ChiThang12/Design_SoC_RISCV_ASCON/paper2/paper2_2/H1+H3.md

📋 BRIEFING DOCUMENT TỔNG HỢP – H1 + H3 TRÊN NỀN DUAL-CORE
1. BỐI CẢNH VÀ ĐỊNH HƯỚNG
Nền tảng: SoC RISC-V 5-stage, AXI4 crossbar, DCache/ICache, ASCON crypto accelerator với DMA.

Vấn đề gốc: DMA và cache không đồng bộ, phần mềm phải dùng fence/flush/invalidate nên tốn cycles và làm driver phức tạp.

Baseline đã khóa: selective coherent DMA và dual-core coherency đã có functional closure. Điều đó không còn là mục tiêu chính nữa, mà là nền ổn định để chuyển sang hai hướng mới:
- H3: Multi-Context ASCON
- H1: Compute-in-Cache

Mục tiêu hiện tại:
- chốt H3 trước để có kiến trúc context switching rõ ràng
- sau đó mở H1 để đẩy bài toán từ coherency sang processing tại chỗ trong cache

2. NỀN TẢNG ĐÃ ỔN
2.1. Những gì đã hoàn thành
Thành phần	Mô tả	Trạng thái
CPU Core 0 & 1	Hai instance của CPU RISC-V 5-stage, mỗi core có `mhartid` riêng.	✅ Tích hợp
ICache 0 & 1	Cache lệnh riêng.	✅ Tích hợp
DCache 0 & 1	Đã nâng cấp từ valid/dirty sang MESI (I/S/E/M).	✅ Hoàn thành
Snoop Bus 2-way	`dcache_snoop_bus_2way.v` broadcast snoop request đến cả 2 DCache.	✅ Đã code và test
Snoop Arbiter 3-to-1	`dcache_snoop_arb_3to1.v` cấp quyền snoop công bằng hơn.	✅ Đã code
CPU miss -> peer snoop	Khi CPU1 read miss, nó tự động snoop CPU0 để lấy data mới nhất.	✅ Đã chứng minh
DMA sideband snoop	`tb_ascon_dma.v` pass, chứng minh DMA có thể snoop read và invalidate.	✅
Firmware dual-core	`basic`, `cache_sweep`, `fence_flush`, `peer_snoop` đều PASS.	✅
ASCON DMA end-to-end dual-core	`test_dualcore_ascon_dma_coherent` PASS ở mức SoC dual-core.	✅

2.2. Ý nghĩa của baseline
- Đây là nền đủ chắc để không phải quay lại sửa coherency core nữa.
- Đây là phần H3/H1 sẽ kế thừa, không phải phần cần mở rộng thêm trước tiên.
- Mọi số liệu mới nên được gắn vào H3/H1, không chỉ dừng ở “dual-core pass”.

2.3. Baseline số liệu đã chốt cho paper
Các số đo dưới đây đã được refresh ngày 2026-06-29 từ unified SoC TB:

| Chỉ số baseline | Giá trị |
| --- | ---: |
| `test_dualcore_peer_snoop` consumer `c2c_fwds` | 3 |
| `test_dualcore_peer_snoop` consumer `peer_snp_hits` | 3 |
| `test_dualcore_ascon_dma_coherent` `core0_dc_req_count` | 12437 |
| `test_dualcore_ascon_dma_coherent` `core1_dc_req_count` | 12527 |
| contention `forward-hit + DMA` cycles | 49957 |
| contention `forward-hit + DMA` consumer `c2c_fwds` | 10 |
| contention `fallback-refill + DMA` cycles | 81320 |
| contention `fallback-refill + DMA` consumer `c2c_fwds` | 2 |

Ý nghĩa trực tiếp cho bài báở:
- baseline coherency không chỉ pass chức năng mà còn đã có counter định lượng cho peer snoop và direct cache-to-cache forwarding
- dưới tải CPU/DMA đồng thời, direct forwarding cho completion time thấp hơn rõ rệt: `49957` cycles so với `81320` cycles
- tỷ lệ cải thiện hiện tại là khoảng `1.63x`, đủ tốt để dùng làm mốc so sánh khi mở H3 và H1

3. H3 TRƯỚC, RỒI MỚI H1
3.1. H3 – Multi-Context ASCON
Ý tưởng: ASCON core lưu nhiều context (key, nonce, state) trong một Context Register File (CRF). CPU/DMA chỉ cần gửi `context_id` khi khởi tạo, ASCON sẽ switch context nhánh mà không cần lưu/load qua bus.

Lợi ích:
- giảm overhead context switch từ hàng trăm cycles xuống rất thấp
- hỗ trợ nhiều ứng dụng/người dùng cùng lúc trên các core khác nhau
- giữ isolation giữa các context

Kế thừa từ baseline:
- đã có dual-core để chia workload theo core
- đã có DMA `coh_ctrl` và sideband path để thread thêm `context_id`
- đã có firmware/testbench framework để đo context overhead

3.2. H1 – Compute-in-Cache
Ý tưởng: Đưa một ASCON datapath nhỏ vào DCache Controller. Khi CPU hoặc DMA truy cập vùng crypto, cache controller tự xử lý dữ liệu ngay trong cache line, giảm data movement qua accelerator.

Lợi ích:
- giảm traffic bus giữa cache và accelerator
- tăng locality và giảm latency cho dữ liệu đã được xử lý
- mở hướng kiến trúc “compute at the edge of the cache”

Rủi rõ chính:
- latency nếu line chưa được xử lý xong
- complexity ở metadata và queueing
- phải giữ coherency hiện tại không vỡ

Giải pháp dự kiến:
- thêm `crypto_pending` cho line đang chờ xử lý
- thêm queue/batching cho các line crypto
- chỉ áp dụng cho vùng địa chỉ crypto, không đụng vùng còn lại

4. ROADMAP HIỆN TẠI
Giai đoạn 0: Chốt H3 trên baseline dual-core
Tuần	Công việc
1	Thêm `context_id` plumbing từ ASCON top xuống DMA và firmware.
2	Thêm `CONTEXT_SEL` / CRF và viết TB dual-core cho 2 context độc lập.
Sản phẩm: H3 baseline hoàn chỉnh.

Giai đoạn 1: Đo và chốt số liệu H3
Tuần	Công việc
1	Đở throughput theo số context.
2	Đở context-switch latency và isolation overhead.
3	So sánh baseline DMA vs H3.
Sản phẩm: paper H3.

Giai đoạn 2: Mở H1
Tuần	Công việc
1-2	Thiết kế `crypto_pending` và queue/batching trong DCache.
3-4	Tích hợp ASCON datapath thử nghiệm vào DCache.
5	Viết TB: CPU ghi plaintext -> cache xử lý -> CPU đọc ciphertext.
6	Đở throughput, latency, energy proxy.
Sản phẩm: paper H1.

Giai đoạn 3: Tổng hợp H1 + H3
- Nếu H3 và H1 đều ổn, có thể gộp thành một story lớn về crypto accelerator with multi-context and compute-in-cache support.

5. THỨ GÌ CẦN ĐỞ THÊM
Để H1/H3 đủ “paper-ready”, còn thiếu các nhóm số liệu sau:
- H3: context-switch latency, throughput theo số context, isolation overhead
- H1: latency, throughput, energy proxy, queue occupancy
- baseline comparison: selective coherent DMA vs H3 vs H1
- system metrics: miss/hit rate theo benchmark H3/H1, và bảng so sánh tiếp nói trên baseline contention đã có

6. TÀI LIỆU THAM CHIẾU
Các file đang nên đọc cùng nhau:
- `paper2/paper2_2/dualcore_test_results.md`
- `paper2/paper2_2/dualcore_missing_items.md`
- `paper2/paper2_2/rtl_coherency_checklist.md`
- `paper2/paper2_2/rtl_coherency_audit.md`
- `paper2/paper2_2/dualcore_test_commands.md`

7. KẾT LUẬN NGẮN
- Dual-core coherency đã là baseline ổn định.
- H3 là bước tiếp theo hợp lý nhất vì nó mở rộng control plane của ASCON mà chưa phá data path.
- H1 là bước tiếp theo sau H3 vì nó cần nền coherency đã ổn để nhúng compute vào cache.
- Từ thời điểm này, tài liệu trong `paper2/paper2_2` nên được đọc như một bộ chốt cho H1/H3, không còn là một paper dual-core riêng lẻ.
