ChiThang12/Design_SoC_RISCV_ASCON/plan/weak1/EXECUTIVE_SUMMARY.md

# EXECUTIVE SUMMARY - RISC-V CPU-HS Analysis

**Analysis Date:** May 1, 2026  
**Target:** High-Performance 5-stage Pipeline RISC-V CPU (without Multiplier)  
**Scope:** Bug analysis + fix recommendations

---

## KEY FINDINGS

### ✅ ASSESSMENT: 100% CORRECT

Báo cáo ban đầu **100% chính xác** khi loại bỏ multiplier issues.

**3 CRITICAL BUGS xác nhận:**

1. **FENCE Deadlock** - 🔴 **BLOCKING**
   - **What:** FENCE instruction causes permanent pipeline stall khi có pending load + store
   - **Why:** `req_ready = fence ? 0` blocks drain FSM từ issuing requests
   - **Scenario:** `lw x1 (miss) → sw x2 → fence` → **CRASH**
   - **Fix:** Allow drain to proceed independently of fence signal

2. **LSU Cache Miss Hazard** - 🔴 **BLOCKING**
   - **What:** Hazard detection không track multi-cycle load latency chính xác
   - **Why:** Scoreboard chỉ biết "load pending" không biết "khi nào ready"
   - **Scenario:** Load miss (10 cycles) + dependent instruction → stall time không đúng
   - **Fix:** Export `load_multi_cycle` signal, adjust stall calculation

3. **IRQ Timing Race** - 🟡 **EDGE CASE**
   - **What:** If `irq_pending` and `irq_flush_done` both high → race condition
   - **Why:** `else if` precedence not explicit
   - **Impact:** IRQ latency variation, possible missed interrupt
   - **Fix:** Explicit `if-else` priority

---

## CRITICALITY MATRIX

```
          Probability    Impact    Fix Effort    ACTION
          -----------    ------    ----------    ------
FENCE     HIGH           CRASH     1 day         MUST FIX NOW
LSU       HIGH           WRONG     2 days        MUST FIX NOW
IRQ       MEDIUM         EDGE      2 hours       FIX AFTER OTHERS
```

---

## TIMELINE

| Phase | Task | Duration | Owner |
|---|---|---|---|
| **Week 1** | FENCE deadlock fix + test | 1 day | RTL Engineer |
| **Week 1** | LSU hazard fix + test | 2 days | RTL Engineer |
| **Week 1** | IRQ timing fix | 2 hours | Verification |
| **Week 2** | Integration + regression | 2 days | Verification |
| **Week 2** | Performance benchmark | 1 day | Perf Team |
| **Week 3** | Final sign-off | 1 day | Lead |

**Total before tape-out:** ~1.5 weeks

---

## IMPLEMENTATION GUIDES

### FENCE FIX (Recommended: Option B)

```verilog
// LSU.v - Add fence-pending tracking
reg fence_pending_r;
always @(posedge clk) begin
    if (fence && !lsu_idle) fence_pending_r <= 1'b1;
    else if (lsu_idle) fence_pending_r <= 1'b0;
end

// Drain FSM - Start drain when fence pending
if ((!sb_empty || fence_pending) && !load_using_dcache)
    drain_state <= DRAIN_REQ;
```

### LSU FIX

```verilog
// LSU.v - Export load state
output wire load_multi_cycle;
assign load_multi_cycle = (load_state == LOAD_DCACHE);

// hazard_detection.v - Use load latency info
assign lsu_dep_stall = lsu_dependency_stall || 
                       (lsu_dependency_stall && load_multi_cycle);
```

### IRQ FIX

```verilog
// riscv_cpu_core_v2.v - Explicit priority
else if (irq_flush_done)       // Priority 1: clear
    irq_pending_lat <= 1'b0;
else if (irq_pending)           // Priority 2: set
    irq_pending_lat <= 1'b1;
```

---

## TESTING REQUIREMENTS

### FENCE Deadlock
```risc-v
lw x1, BIG_OFFSET(x2)    # Cache miss
sw x3, 0(x4)              # Store 1
sw x5, 4(x4)              # Store 2
fence                      # Must not deadlock!
```

### LSU Cache Miss
```risc-v
lw x1, MISS(x2)           # 10+ cycle miss
add x3, x1, x4            # Should stall exactly right amount
```

### IRQ Timing
Simulate: IRQ assertion during flush → verify clean priority

---

## DESIGN IMPACT ASSESSMENT

| Fix | Code Impact | Performance | Risk |
|-----|---|---|---|
| FENCE | +15 lines | Neutral | Low - isolated to LSU |
| LSU | +5 lines | Neutral | Low - output signal only |
| IRQ | 3 lines | Neutral | Very low - edge case |

**Total:** ~23 lines of code, **backward compatible**, **low risk**

---

## VERIFICATION SIGN-OFF

- [ ] FENCE simulation passes (test deadlock case)
- [ ] LSU miss simulation passes (test hazard stall window)
- [ ] IRQ priority simulation passes (test race condition)
- [ ] Full regression suite passes
- [ ] Performance within spec
- [ ] Code review approved
- [ ] Ready for tape-out

---

## OPEN ITEMS

### FENCE
- [ ] Confirm with verification team on fence semantics
- [ ] Check if fence needs to block NEW requests (yes, req_ready stays 0)
- [ ] Ensure drain priority vs load priority is correct

### LSU
- [ ] Verify forwarding logic handles load result timing correctly
- [ ] Check coverage on multi-cycle load paths
- [ ] Performance impact of extra stall?

### IRQ
- [ ] Confirm IRQ latency requirement (<50 cycles? or faster?)
- [ ] Check if RISC-V privilege spec has strict requirements

---

## CONCLUSION

**Status:** 3 bugs confirmed, **all fixable in 1-2 weeks**

**Recommendation:** 
1. Apply FENCE fix IMMEDIATELY (highest priority)
2. Integrate LSU fix + comprehensive testing
3. Quick IRQ timing fix + edge case verification
4. Full regression before tape-out

**Go/No-Go for Tape-out:** **NO GO** until all 3 fixes verified
- FENCE deadlock = CPU unusable for shared memory code
- LSU miss hazard = potential data corruption
- IRQ timing = less critical but needs validation

---

## REFERENCE

- **Full Analysis:** ANALYSIS_SUMMARY.md
- **Code Patches:** FIXES_IMPLEMENTATION.md
- **Source Code:** All .v files included

Contact: RTL Verification Team for questions on implementation
