ChiThang12/Design_SoC_RISCV_ASCON/📄 PAPER 2.docx

📄 PAPER 2: Zero-Copy Coherent DMA + Address-Offset

Tiêu đề dự kiến: "Eliminating Software Cache Flush Overheads: A Hardware-Coherent DMA Engine for ASCON Cryptographic Accelerator on RISC-V"
Mục tiêu: Tập trung vào tối ưu hóa Hệ thống (Cache, Bus, DMA - Hướng #4).

Section | Nội dung cần điền | Gợi ý số từ
Abstract | (Viết sau cùng) Tóm tắt: (1) Vấn đề: DMA và Cache không đồng bộ, phần mềm phải flush/invalidate gây ra overhead lớn. (2) Giải pháp: Đề xuất cơ chế coherency phần cứng (Snoop + ATU) cho ASCON DMA. (3) Kết quả: Giảm 70% latency, loại bỏ hoàn toàn lệnh CBO, tiết kiệm năng lượng. | 150-200 từ
I. Introduction | Đoạn 1: Giới thiệu SoC RISC-V với DMA cho crypto. Đoạn 2: Vấn đề nhức nhối của hệ thống nhúng là sự không đồng bộ Cache-Memory khi DMA hoạt động (dẫn đến data corruption nếu không flush). Đoạn 3: Các giải pháp hiện tại (Linux DMA_API, Zicbom extension) đều là Software Coherency -> Tốn CPU cycles và phức tạp. Đoạn 4 (Đóng góp): Lần đầu tiên tích hợp cơ chế Snoop phần cứng và ATU (Address Translation Unit) cho DMA Crypto, biến DMA thành một "Master có nhận thức về Cache". | 400-500 từ
II. Background & Motivation | 2.1 RISC-V Cache & CMOs: Giải thích DCache (8KB), các lệnh CBO.CLEAN, CBO.INVAL trong extension Zicbom. 2.2 The Software Coherency Overhead: Đưa ra code mẫu (Pseudo-code) phần mềm phải flush trước khi chạy DMA và invalidate sau. Tính toán thời gian tốn kém cho 1KB dữ liệu. 2.3 Related Work: CHIMERA và Ma'at vẫn dùng phần mềm để làm việc này. Không có giải pháp HW Coherency. | 500-600 từ
III. Proposed Hardware-Coherent DMA | A. Address Translation Unit (ATU): Giải thích cơ chế ánh xạ địa chỉ ảo 0x2500_0000 sang địa chỉ thật 0x1000_0000 để CPU và DMA dùng chung vùng nhớ. B. Snoop Interface: Mô tả giao tiếp trực tiếp (point-to-point) giữa DMA và DCache Controller. C. Coherency Protocol (MESI/MEI): Mô tả cách DMA thay đổi trạng thái Cache (Modified -> Shared, hoặc Invalidate). D. DMA FSM Modification: Sơ đồ trạng thái mới của DMA (thay vì chỉ Read/Write, nó phải gửi Snoop_Req trước mỗi giao dịch). | 700-900 từ + 2 hình
IV. Verification & Evaluation | A. FPGA Prototyping: Cài đặt trên FPGA. B. Performance (Latency): So sánh thời gian thực hiện 1 phép mã hóa (Setup + DMA + Core) giữa Baseline (có flush) và Proposed (không flush). C. CPU Utilization: Đo % thời gian CPU bị stall do đợi cache flush. D. Bus Traffic: Đo số lượng giao dịch AXI giảm được (do không phải write-back dirty data vô ích). E. Energy Saving: Ước tính năng lượng tiết kiệm được (dựa trên toggle count). | 400-500 từ + Bảng so sánh
V. Conclusion | Khẳng định giải pháp phần cứng đã giải quyết được bài toán "cache coherency" cho Crypto Accelerator, giúp firmware đơn giản hơn và system mạnh mẽ hơn.

📄 BRIEFING DOCUMENT #2: PAPER ON HARDWARE-COHERENT DMA

Tiêu đề dự kiến: Eliminating Software Cache Flush Overheads: A Hardware-Coherent DMA Engine for ASCON Cryptographic Accelerator on RISC-V

1. Bối cảnh (Context)

- SoC RISC-V thường có cache (I-cache, D-cache) để tăng tốc CPU.
- DMA (Direct Memory Access) được dùng để chuyển dữ liệu giữa memory và ngoại vi mà không cần CPU.
- Trong SoC đề xuất, ASCON engine có DMA riêng để đọc plaintext và ghi ciphertext.

2. Vấn đề (Problem)

- Cache và DMA không đồng bộ: CPU ghi dữ liệu vào cache (write-back) nhưng DMA đọc từ memory → DMA đọc dữ liệu cũ. DMA ghi dữ liệu mới vào memory nhưng CPU đọc từ cache → CPU đọc dữ liệu cũ.
- Giải pháp hiện tại (Software Coherency): Phần mềm driver phải gọi lệnh CBO.CLEAN (flush) trước khi DMA đọc, và CBO.INVAL (invalidate) sau khi DMA ghi. Cách này tốn nhiều chu kỳ, tăng latency, và phức tạp cho lập trình viên.
- Các accelerator ASCON trước đây (CHIMERA, Ma'at, SCAIE-V) đều dùng software coherency này.

3. Điểm mới (Novelty)

- Lần đầu tiên đề xuất Hardware Cache Coherency cho DMA của ASCON trên RISC-V.
- DMA có khả năng Snoop vào DCache để lấy dữ liệu mới nhất (thay vì đọc từ memory) và invalidate cache lines sau khi ghi.
- Kết hợp Address Translation Unit (ATU) để CPU và DMA chia sẻ vùng nhớ ảo, không cần flush/invalidate thủ công.

4. Giải pháp tóm tắt (Proposed Solution)

- ATU (Address Translation Unit):
  - Ánh xạ địa chỉ ảo của DMA (0x2500_0000) sang địa chỉ thật trong memory (0x1000_0000).
  - Cho phép CPU và DMA làm việc trên cùng vùng nhớ vật lý một cách trong suốt.
- Snoop Interface (point-to-point):
  - DMA gửi request snoop tới DCache Controller trước khi đọc: "Địa chỉ X có trong cache không? Cho tao xin dữ liệu mới nhất."
  - DMA gửi request snoop sau khi ghi: "Tao vừa ghi vào địa chỉ Y, mày invalidate cache line đó đi."
- Coherency Protocol:
  - Sử dụng trạng thái MESI (Modified, Exclusive, Shared, Invalid) hoặc đơn giản hóa (MEI).
  - DCache Controller quản lý trạng thái và trả lời snoop.
- DMA FSM: Thêm các trạng thái SNOOP_READ, SNOOP_WRITE trước khi thực hiện AXI transaction.

5. Các công trình liên quan (Related Works) và hạn chế

Công trình | Cách xử lý coherency | Hạn chế
CHIMERA (2025) | Software flush/invalidate (dùng Zicbom) | Tốn CPU cycles, phức tạp driver
Ma'at (2026) | Software invalidate trước DMA đọc | Overhead lớn, không tối ưu
SCAIE-V (2025) | Software fallback với cache flush | Không hỗ trợ hardware snoop
Linux DMA-API | Software coherency (dùng APIs) | Phụ thuộc vào OS, overhead cao
ARM ACE (AXI Coherency) | Hardware snoop | Chưa được áp dụng cho RISC-V crypto DMA

=> Chưa có công trình nào implement hardware snoop cho DMA của ASCON trên RISC-V.

6. Số liệu cần đo và kỳ vọng (Expected Metrics)

Metric | Baseline (software flush) | Proposed (HW snoop) | Target Improvement
DMA setup latency (cycles) | đo | đo | giảm > 50%
Total encryption time (cycles) | đo | đo | giảm > 40%
CPU stall time (%) | đo | đo | giảm > 60%
Bus transactions (count) | đo | đo | giảm > 30%
Energy (μJ/op) | đo | đo | giảm > 30%
Driver code size (lines) | đo | đo | giảm > 50%

7. Các hình vẽ cần có (Key Figures)

- Fig 1: Sơ đồ tổng thể SoC với snoop path mới (DMA → DCache).
- Fig 2: Sơ đồ FSM của DMA với các trạng thái snoop.
- Fig 3: Biểu đồ so sánh latency giữa software flush và hardware snoop (bar chart).
- Fig 4: Biểu đồ giảm bus traffic và CPU stall (grouped bar chart).

8. Bảng so sánh cần có

- Bảng so sánh các phương pháp coherency (software vs hardware) về latency, CPU overhead, code complexity.
- Bảng so sánh resource utilization trước/sau khi thêm snoop (LUT, FF, routing).
