ChiThang12/Design_SoC_RISCV_ASCON/paper2/plan_paper2.md

# Xem `02_plan_new_arch.md`

File này đã được tách sang tài liệu chuẩn:
- `paper2/02_plan_new_arch.md`

Tài liệu gốc về mục tiêu kiến trúc mới vẫn được giữ nguyên, chỉ đổi vị trí để tách rõ:
- baseline kiến trúc cũ
- kế hoạch kiến trúc mới
- bảng so sánh kết quả
