ChiThang12/Design_SoC_RISCV_ASCON/memory/MEMORY_UPGRADE_ANALYSIS.md

# Memory Modules Analysis Report

## Executive Summary

**Kết luận**: CẦN upgrade 1 module và giữ nguyên 1 module:

### ✅ **inst_mem_axi_slave.v** - SẴN SÀNG cho ICache!
- Đã support **AXI4 Full** với burst read
- Có burst interface hoàn chỉnh (ARLEN, ARSIZE, ARBURST, RLAST)
- inst_mem.v đã có burst read state machine
- **KHÔNG CẦN SỬA**

### ❌ **data_mem_axi_slave.v** - CẦN UPGRADE lên AXI4 Full
- Hiện tại chỉ support **AXI4-Lite** (single transfer)
- Thiếu burst support (ARLEN, AWLEN, RLAST, WLAST)
- data_mem.v không có burst interface
- **CẦN UPGRADE** để DCache hoạt động tốt

---

## Detailed Analysis

### 1. inst_mem_axi_slave.v ✅

#### Current Status: READY FOR ICACHE

**Ports đã có:**
```verilog
// Read Address Channel
input [7:0]  S_AXI_ARLEN     ✅ Burst length
input [2:0]  S_AXI_ARSIZE    ✅ Transfer size
input [1:0]  S_AXI_ARBURST   ✅ Burst type

// Read Data Channel  
output       S_AXI_RLAST     ✅ Last transfer indicator

// Write Channels
// Properly tied off - returns SLVERR ✅
```

**Features:**
- ✅ AXI4 Full burst read support
- ✅ State machine handles burst transactions
- ✅ inst_mem.v has burst interface with:
  - burst_addr, burst_len, burst_req
  - burst_data, burst_valid, burst_last, burst_ready
- ✅ Read-only (write returns SLVERR)

**Compatibility with ICache:**
```
ICache → inst_mem_axi_slave
  ARADDR[31:0] → S_AXI_ARADDR[31:0]  ✅
  ARLEN[7:0]   → S_AXI_ARLEN[7:0]    ✅
  ARSIZE[2:0]  → S_AXI_ARSIZE[2:0]   ✅
  ARBURST[1:0] → S_AXI_ARBURST[1:0]  ✅
  RLAST        ← S_AXI_RLAST         ✅
  
Perfect match! 100% compatible!
```

**Verdict**: **NO CHANGES NEEDED** ✅

---

### 2. data_mem_axi_slave.v ❌

#### Current Status: NEEDS UPGRADE

**Current Interface: AXI4-Lite**
```verilog
// Missing AXI4 Full signals:
❌ input [7:0]  S_AXI_ARLEN     // Not present
❌ input [2:0]  S_AXI_ARSIZE    // Not present
❌ input [1:0]  S_AXI_ARBURST   // Not present
❌ output       S_AXI_RLAST     // Not present

❌ input [7:0]  S_AXI_AWLEN     // Not present
❌ input [2:0]  S_AXI_AWSIZE    // Not present
❌ input [1:0]  S_AXI_AWBURST   // Not present
❌ output       S_AXI_WLAST     // Not present
```

**Current Behavior:**
- Single transfer only (no burst)
- State machine: IDLE → WAIT → RESP (one beat)
- data_mem.v: Simple read/write, no burst interface

**Required Changes for DCache:**

DCache needs burst support for efficient line fills:
```
Cache line = 16 bytes (4 words)
→ Need 4-beat burst read
→ Need burst write for write-through
```

**Impact Assessment:**

| Operation | Current (AXI4-Lite) | Needed (AXI4 Full) | Impact |
|---|---|---|---|
| Read 4 words | 4 separate transactions | 1 burst (4 beats) | Critical |
| Write 1 word | 1 transaction | 1 transaction | OK |
| Write burst | N/A | 1 burst (optional) | Nice to have |

---

## Upgrade Strategy for data_mem_axi_slave.v

### Option 1: Full Upgrade (Recommended)

**Copy approach from inst_mem_axi_slave.v:**

```verilog
// 1. Add AXI4 Full ports
input [7:0]  S_AXI_ARLEN,
input [2:0]  S_AXI_ARSIZE,
input [1:0]  S_AXI_ARBURST,
output       S_AXI_RLAST,

input [7:0]  S_AXI_AWLEN,
input [2:0]  S_AXI_AWSIZE,
input [1:0]  S_AXI_AWBURST,
input        S_AXI_WLAST,

// 2. Modify read state machine
RD_IDLE → RD_BURST (similar to inst_mem)

// 3. Modify write state machine  
WR_IDLE → WR_ADDR → WR_BURST → WR_RESP

// 4. Upgrade data_mem.v with burst interface
```

**Estimated effort**: 2-3 hours
**Code reuse**: 70% from inst_mem_axi_slave.v
**Benefits**: Full AXI4 Full support, efficient cache line fills

---

### Option 2: Minimal Upgrade (Faster)

**Keep AXI4-Lite for writes, add burst read only:**

```verilog
// Only add read burst support
input [7:0]  S_AXI_ARLEN,
output       S_AXI_RLAST,

// Write stays single-transaction (OK for write-through)
// No AWLEN, WLAST needed
```

**Rationale:**
- DCache read misses need burst (4 words)
- DCache writes are single words (write-through)
- Simpler implementation

**Estimated effort**: 1 hour
**Code reuse**: 80% from existing code
**Benefits**: Faster implementation, sufficient for write-through cache

---

## Recommended Implementation Plan

### Step 1: Keep inst_mem_axi_slave.v AS-IS ✅
No changes needed!

### Step 2: Upgrade data_mem_axi_slave.v

**Approach: Option 1 (Full Upgrade)** - More future-proof

#### 2A. Upgrade data_mem.v first
Add burst interface similar to inst_mem.v:

```verilog
module data_mem (
    // ... existing ports ...
    
    // ADD: Burst read interface
    input  [31:0] burst_rd_addr,
    input  [7:0]  burst_rd_len,
    input         burst_rd_req,
    output [31:0] burst_rd_data,
    output        burst_rd_valid,
    output        burst_rd_last,
    input         burst_rd_ready,
    
    // ADD: Burst write interface (optional)
    input  [31:0] burst_wr_addr,
    input  [7:0]  burst_wr_len,
    input  [31:0] burst_wr_data,
    input  [3:0]  burst_wr_strb,
    input         burst_wr_valid,
    output        burst_wr_ready,
    input         burst_wr_last
);
```

#### 2B. Upgrade data_mem_axi_slave.v
Copy structure from inst_mem_axi_slave.v:

```verilog
// 1. Add all AXI4 Full ports (ARLEN, AWLEN, RLAST, WLAST, etc.)
// 2. Add burst state machines (read + write)
// 3. Connect to data_mem burst interface
```

**Files to create:**
- `data_mem_axi4_slave.v` (new, based on inst_mem_axi_slave.v)
- `data_mem_burst.v` (upgrade of data_mem.v)

---

## Compatibility Matrix

| Component | ICache | DCache | Status |
|---|---|---|---|
| **inst_mem_axi_slave.v** | ✅ Compatible | N/A | READY |
| **inst_mem.v** | ✅ Has burst | N/A | READY |
| **data_mem_axi_slave.v** | N/A | ❌ Lite only | NEEDS UPGRADE |
| **data_mem.v** | N/A | ❌ No burst | NEEDS UPGRADE |

---

## Testing Strategy

### Phase 1: Verify inst_mem works with ICache
```
1. Connect ICache to existing inst_mem_axi_slave
2. Test single read (1 word)
3. Test burst read (4 words for cache line)
4. Verify RLAST signal
5. Check hit/miss behavior
```

**Expected**: Works immediately! ✅

### Phase 2: Test upgraded data_mem with DCache
```
1. Create data_mem_burst.v
2. Create data_mem_axi4_slave.v
3. Test single read/write
4. Test burst read (4 words)
5. Test write-through behavior
6. Verify RLAST/WLAST signals
```

**Expected**: Works after upgrade

---

## Code Reuse Calculation

### For data_mem upgrade:

**From inst_mem.v → data_mem_burst.v:**
- Burst read state machine: 100% reuse (~80 lines)
- Memory array access: Modify for byte-enable (~20 lines new)
- **Total: 90% reuse**

**From inst_mem_axi_slave.v → data_mem_axi4_slave.v:**
- Read channel logic: 90% reuse (~120 lines)
- Write channel logic: Modify existing (~50 lines)
- Burst management: 80% reuse (~40 lines)
- **Total: 85% reuse**

**Overall new code needed: ~100 lines**

---

## Summary Table

| Task | Status | Effort | Files |
|---|---|---|---|
| inst_mem_axi_slave.v | ✅ Ready | 0 hours | None |
| inst_mem.v | ✅ Ready | 0 hours | None |
| data_mem.v → data_mem_burst.v | ⚠️ Need | 1 hour | 1 new |
| data_mem_axi_slave.v → data_mem_axi4_slave.v | ⚠️ Need | 2 hours | 1 new |
| **TOTAL** | | **3 hours** | **2 files** |

---

## Next Steps

### Immediate (Today):
1. ✅ Keep inst_mem_axi_slave.v unchanged
2. ⚠️ Create data_mem_burst.v (copy from inst_mem.v + add write burst)
3. ⚠️ Create data_mem_axi4_slave.v (copy from inst_mem_axi_slave.v + add write)

### Short-term (This week):
4. Test ICache with existing inst_mem
5. Test DCache with upgraded data_mem
6. Integration into SOC
7. Benchmark performance

### Files Needed:

**Already have** (no changes):
- inst_mem.v ✅
- inst_mem_axi_slave.v ✅

**Need to create**:
- data_mem_burst.v ⚠️
- data_mem_axi4_slave.v ⚠️

---

## Conclusion

**Good news**: inst_mem đã sẵn sàng cho ICache! Bạn đã chuẩn bị tốt từ trước.

**Action needed**: Chỉ cần upgrade data_mem để support DCache.

**Effort**: ~3 giờ với 85% code reuse từ inst_mem.

**Recommendation**: 
1. Test ICache ngay với inst_mem hiện tại (should work!)
2. Upgrade data_mem trong khi ICache đang work
3. Integrate DCache sau khi upgrade xong

Tôi sẽ tạo 2 files upgrade cần thiết ngay bây giờ!
