ChiThang12/Design_SoC_RISCV_ASCON/📄 PAPER 1.docx

📄 PAPER 1: Multi-Lane Vectorized ASCON Datapath

Tiêu đề dự kiến: "Multi-Lane Vectorized ASCON Datapath: Achieving 4× Throughput for Lightweight Cryptography on RISC-V SoC"
Mục tiêu: Tập trung vào tối ưu hóa Datapath (Phần cứng tính toán bên trong ASCON).

Section | Nội dung cần điền | Gợi ý số từ
Abstract | (Viết sau cùng) Tóm tắt: (1) Vấn đề: ASCON throughput thấp do single-lane. (2) Giải pháp: Đề xuất kiến trúc SIMD/Vector 4-lane. (3) Kết quả: Đạt throughput X Gbps, tăng 4x, diện tích tăng 2.5x. | 150-200 từ
I. Introduction | Đoạn 1: IoT và PQC, ASCON được NIST chuẩn hóa 2023. Đoạn 2: SoC RISC-V đang phổ biến, nhưng CPU xử lý ASCON chậm -> cần Hardware Accelerator. Đoạn 3: Các nghiên cứu trước (CHIMERA, SCAIE-V) chỉ dùng 1 datapath. Họ đạt được area tốt nhưng throughput bị giới hạn. Đoạn 4 (Đóng góp): Bài này đề xuất Vectorized Datapath với 4 lanes, chứng minh trade-off throughput/area vượt trội. | 400-500 từ
II. Preliminaries | 2.1 ASCON Algorithm: Giải thích State (5x64-bit), S-box, vòng lặp Diffusion. Vẽ hình 5 thanh ghi. 2.2 Single-Lane Baseline: Mô tả thiết kế ascon_CORE hiện tại của anh để làm baseline. 2.3 Related Work: So sánh nhanh CHIMERA (tight-coupled), High-Performance FPGA (unrolled). Chỉ ra họ chưa làm Vectorization. | 500-600 từ
III. Proposed Vectorized Architecture | A. Vector State Register: Mở rộng 64-bit thành 256-bit (4 lanes). Mô tả cách lưu trữ dữ liệu song song. B. Vector S-box: Thiết kế 4 S-box song song (dùng LUT hoặc logic). Vẽ sơ đồ khối. C. Diffusion & Rotation: Cách xử lý XOR và xoay vòng cho 4 khối cùng lúc. D. Controller Modification: FSM điều khiển 4 lanes đồng bộ. E. DMA Bus Width: Sửa DMA đọc 256-bit thay vì 64-bit. | 600-800 từ + 2 hình
IV. Implementation & Results | A. FPGA Implementation: Tổng hợp trên Artix-7 / Kintex-7. Bảng tiêu thụ LUT/FF/DSP. B. Performance Metrics: Bảng so sánh Throughput (Gbps), Latency, Fmax với Baseline. C. Area Efficiency: Biểu đồ Throughput/Area (Metric quan trọng). Chứng minh "4x throughput chỉ tốn 2.5x area". D. Power Analysis (nếu có): So sánh năng lượng tiêu thụ (pJ/byte). | 400-500 từ + Bảng + Biểu đồ
V. Conclusion | Tóm tắt lại novelty, nhấn mạnh đây là vectorized datapath đầu tiên cho ASCON, phù hợp cho ứng dụng băng thông cao. Mở hướng mở rộng lên 8 lanes. | 150-200 từ

📄 BRIEFING DOCUMENT #1: PAPER ON VECTORIZED DATAPATH

Tiêu đề dự kiến: Multi-Lane Vectorized ASCON Datapath: Achieving 4× Throughput for Lightweight Cryptography on RISC-V SoC

1. Bối cảnh (Context)

- ASCON là thuật toán mã hóa nhẹ (Lightweight AEAD) được NIST chuẩn hóa vào năm 2023.
- Các hệ thống nhúng/IoT ngày càng yêu cầu băng thông mã hóa cao (camera, giao tiếp thời gian thực).
- Các nghiên cứu gần đây (CHIMERA, SCAIE-V) đã tích hợp ASCON vào RISC-V, nhưng chỉ dùng 1 datapath 64-bit duy nhất (xử lý lần lượt từng block).

2. Vấn đề (Problem)

- Hardware throughput bị giới hạn bởi độ rộng datapath chỉ 64-bit. Dù tăng tần số hay pipelining, vẫn chỉ xử lý được 1 block/chu kỳ (hoặc vài chu kỳ).
- Để đạt throughput cao (hàng Gbps), cần một kiến trúc khác biệt.

3. Điểm mới (Novelty)

- Lần đầu tiên đề xuất Vectorized Datapath cho ASCON: mở rộng datapath từ 1 lane lên 4 lane (SIMD-like).
- Xử lý song song 4 blocks dữ liệu độc lập trong cùng một chu kỳ, tăng throughput lên ~4 lần.
- Thiết kế S-box, State Register, Diffusion hỗ trợ vector mà vẫn duy trì tính tương thích với tiêu chuẩn ASCON.

4. Giải pháp tóm tắt (Proposed Solution)

- State Register: Từ 5×64 = 320-bit lên 5×256 = 1280-bit (4 lanes).
- Vector S-box: 4 khối S-box 5-bit độc lập, thực hiện song song (có thể dùng LUT RAM hoặc logic tổ hợp).
- Diffusion Layer: Mở rộng các phép XOR, rotation và xáo trộn để hoạt động trên 4 lanes cùng lúc.
- Controller: FSM điều khiển chung cho cả 4 lanes, vẫn giữ nguyên số vòng lặp và thứ tự thao tác.
- DMA: Sửa DMA để đọc/ghi 256-bit (4 blocks) một lần, tận dụng burst AXI.

5. Các công trình liên quan (Related Works) và hạn chế

Công trình | Điểm mạnh | Hạn chế
Steinegger & Primas (2020) | Instruction extension, compact | Single-lane, chỉ tăng tốc software
CHIMERA (2025) | Tightly-coupled, low area | Single-lane, throughput thấp
SCAIE-V (2025) | Runtime-reconfigurable | Vẫn single-lane, phần mềm fallback
High-Performance FPGA ASCON (2024) | Pipelining, unrolling | Cũng chỉ single-lane, dùng nhiều tài nguyên
MaskSIMD-lib (2023) | Software bitslicing vector | Chỉ ở mức phần mềm, không phải RTL

=> Không có công trình nào triển khai vectorized datapath ở cấp độ RTL cho ASCON.

6. Số liệu cần đo và kỳ vọng (Expected Metrics)

Metric | Baseline (1-lane) | Proposed (4-lane) | Target Improvement
Throughput (Gbps) | đo | đo | > 3.5×
Fmax (MHz) | đo | đo | > 80% baseline
LUTs | đo | đo | < 3× baseline
BRAM/DSP | đo | đo | < 2× baseline
Energy (pJ/byte) | đo | đo | < 1.5× baseline
Throughput/Area (Gbps/KLUT) | tính | tính | > 1.5× baseline

7. Các hình vẽ cần có (Key Figures)

- Fig 1: Sơ đồ khối so sánh baseline (1-lane) và vectorized (4-lane).
- Fig 2: Cấu trúc State Register mới (5×256).
- Fig 3: Kiến trúc vector S-box (4 S-box song song).
- Fig 4: Đồ thị throughput vs area (scatter plot) so với các công trình khác.

8. Bảng so sánh cần có

- Bảng so sánh resource utilization (LUT, FF, DSP, BRAM).
- Bảng so sánh throughput, latency, Fmax, và energy.
