ChiThang12/Design_SoC_RISCV_ASCON/controller/soc_ctrl_slave_spec.docx

RISC-V + ASCON SoC v3

soc_ctrl_slave — Module Specification

AXI4-Lite/Full Slave Controller | S3 @ 0x3000_0000

Verilog IEEE 1364-2001 | Icarus Verilog compatible

File | soc_ctrl_slave.v
Instance | u_ctrl (trong soc_top.v)
Base Address | 0x3000_0000
Address Space | 0x3000_0000 – 0x3000_0FFF (4 KB)
AXI Protocol | AXI4-Full (single-beat only)
Data Width | 32-bit
ID Width | 4-bit
Language | Verilog 2001 – IEEE 1364-2001
Simulator | Icarus Verilog / GTKWave

# 1. Tổng Quan (Overview)

soc_ctrl_slave là AXI4-Lite slave tại S3 (địa chỉ 0x3000_0000) của crossbar axi4_crossbar_3m4s. Module cung cấp các thanh ghi điều khiển SoC cho firmware chạy trên RISC-V CPU: system ID, soft reset, interrupt mask/status và debug counters.

⚠ SoC hiện tại THIẾU module này → S3 trả DECERR với mọi access → firmware trap / loop ngay khi khởi động. Thêm module này là bước quan trọng nhất để fix simulation.

## 1.1 Vị Trí trong SoC

Slave | Địa Chỉ | Module | Trạng Thái
S0 – IMEM | 0x0000_0000 – 0x0000_FFFF | inst_mem_axi_slave.v | ✓ Có sẵn
S1 – DMEM | 0x1000_0000 – 0x1000_FFFF | data_mem_axi_slave.v | ✓ Có sẵn
S2 – ASCON | 0x2000_0000 – 0x2000_0FFF | ascon_ip_top / ascon_top.v | ✓ Có sẵn
S3 – CTRL | 0x3000_0000 – 0x3000_0FFF | soc_ctrl_slave.v | ✓ Module mới (tài liệu này)

# 2. Register Map

Tất cả offset tính từ base address 0x3000_0000. Data width 32-bit. Địa chỉ reserved (0x028–0xFFF) trả 0x00000000 (OKAY response), ghi bị ignore.

Offset | Tên | Access | Reset Value | Mô Tả
0x000 | SYS_ID | RO | 0xASC0_0001 | System ID cố định. Firmware đọc để xác nhận SoC boot đúng.
0x004 | SYS_CTRL | RW | 0x00000000 | Bit[0] = soft_rst toàn SoC (self-clearing, 1 cycle). Bit[31:1] = reserved.
0x008 | IRQ_STATUS | RO/W1C | 0x00000000 | Bit[0] = ascon_irq sticky. Set khi rising edge ascon_irq. Ghi 1 để clear (W1C).
0x00C | IRQ_MASK | RW | 0x00000000 | Bit[0] = ascon_irq enable. 1=enable, 0=masked.
0x010 | ICACHE_HITS | RO | – | Forward icache_hits input. Reset về 0 khi SYS_CTRL[0]=1.
0x014 | ICACHE_MISS | RO | – | Forward icache_misses input.
0x018 | DCACHE_HITS | RO | – | Forward dcache_hits input.
0x01C | DCACHE_MISS | RO | – | Forward dcache_misses input.
0x020 | DCACHE_WR | RO | – | Forward dcache_writes input.
0x024 | CYCLE_CNT | RO | 0x00000000 | 32-bit free-running clock counter. Wrap-around. Reset khi rst_n=0 hoặc SYS_CTRL[0]=1.
0x028–0xFFF | reserved | – | 0x00000000 | Đọc trả 0, ghi ignore. Response OKAY (không DECERR).

# 3. Danh Sách Port

## 3.1 Clock & Reset

Port | Dir | Width | Mô Tả
clk | input | 1 | Clock hệ thống
rst_n | input | 1 | Reset active-LOW (soc_top dùng rst_n). Bên trong logic: posedge clk / negedge rst_n

## 3.2 AXI4-Full Slave Port (S3)

Crossbar kết nối AXI4-Full signals nhưng slave chỉ xử lý single-beat (AWLEN=0, ARLEN=0). AWLEN, ARLEN, WLAST được khai báo là input nhưng bỏ qua bên trong.

Port | Dir | Width | Kênh | Ghi Chú
S_AXI_AWID | input | ID_WIDTH | AW | Write address ID
S_AXI_AWADDR | input | ADDR_WIDTH | AW | Write address
S_AXI_AWLEN | input | 8 | AW | Burst length – ignored (single-beat)
S_AXI_AWSIZE | input | 3 | AW | Burst size
S_AXI_AWBURST | input | 2 | AW | Burst type
S_AXI_AWPROT | input | 3 | AW | Protection type
S_AXI_AWVALID | input | 1 | AW | Address valid
S_AXI_AWREADY | output | 1 | AW | Slave ready (= !aw_done)
S_AXI_WDATA | input | DATA_WIDTH | W | Write data
S_AXI_WSTRB | input | DATA_WIDTH/8 | W | Byte enable strobe
S_AXI_WLAST | input | 1 | W | Last beat – ignored
S_AXI_WVALID | input | 1 | W | Write data valid
S_AXI_WREADY | output | 1 | W | Slave ready (= !w_done)
S_AXI_BID | output | ID_WIDTH | B | Response ID = latched AWID
S_AXI_BRESP | output | 2 | B | OKAY(00) or SLVERR(10)
S_AXI_BVALID | output | 1 | B | Response valid
S_AXI_BREADY | input | 1 | B | Master ready
S_AXI_ARID | input | ID_WIDTH | AR | Read address ID
S_AXI_ARADDR | input | ADDR_WIDTH | AR | Read address
S_AXI_ARLEN | input | 8 | AR | Burst length – ignored
S_AXI_ARSIZE | input | 3 | AR | Burst size
S_AXI_ARBURST | input | 2 | AR | Burst type
S_AXI_ARPROT | input | 3 | AR | Protection type
S_AXI_ARVALID | input | 1 | AR | Address valid
S_AXI_ARREADY | output | 1 | AR | Slave ready (= !ar_done)
S_AXI_RID | output | ID_WIDTH | R | Read ID = latched ARID
S_AXI_RDATA | output | DATA_WIDTH | R | Read data
S_AXI_RRESP | output | 2 | R | OKAY(00) cho mọi địa chỉ
S_AXI_RLAST | output | 1 | R | Luôn = 1'b1 (single-beat)
S_AXI_RVALID | output | 1 | R | Read data valid
S_AXI_RREADY | input | 1 | R | Master ready

## 3.3 SoC Status Inputs

Port | Dir | Width | Nguồn (soc_top) | Mô Tả
icache_hits | input | 32 | icache_top | ICache hit counter (forwarded → reg 0x010)
icache_misses | input | 32 | icache_top | ICache miss counter (forwarded → reg 0x014)
dcache_hits | input | 32 | dcache_top | DCache hit counter (forwarded → reg 0x018)
dcache_misses | input | 32 | dcache_top | DCache miss counter (forwarded → reg 0x01C)
dcache_writes | input | 32 | dcache_top | DCache write counter (forwarded → reg 0x020)
ascon_irq | input | 1 | ascon_ip_top | IRQ từ ASCON IP. Rising edge → sticky IRQ_STATUS[0]

# 4. Kiến Trúc Module (Sub-modules)

Module được chia thành 5 section logic độc lập, được comment rõ ràng trong file .v:

Section | Tên | Chức Năng
[A] | AXI Write Channel | Latch AW & W channel, drive B response. Xử lý SLVERR cho RO registers.
[B] | AXI Read Channel | Latch AR channel, mux register data, drive R response. RLAST=1 (single-beat).
[C] | Register File | Address decode constants, IRQ_MASK reg, CYCLE_CNT 32-bit counter.
[D] | IRQ Sticky Logic | Edge-detect ascon_irq (rising), set IRQ_STATUS sticky, W1C clear.
[E] | Soft-Reset Pulse Generator | Detect SYS_CTRL[0] write, assert soft_rst_pulse 1 cycle, self-clear.

## 4.1 AXI Write Handshake (Section A)

Crossbar có thể gửi AW và W không đồng thời. Module latch cả hai độc lập:

AWVALID ─┐ S_AXI_AWREADY = !aw_done

├─ latch aw_id, aw_addr → aw_done=1

WVALID ─┘ S_AXI_WREADY = !w_done

└─ latch w_data, w_strb → w_done=1

aw_done & w_done & !bvalid_r

→ execute register write

→ assert BVALID (OKAY hoặc SLVERR)

BVALID & BREADY → clear aw_done, w_done, bvalid

## 4.2 AXI Read Handshake (Section B)

ARVALID → latch ar_id, ar_addr → ar_done=1

S_AXI_ARREADY = !ar_done

ar_done & !rvalid → sample rdata_mux → assert RVALID

RVALID & RREADY → clear ar_done, rvalid

RLAST = 1'b1 (always, single-beat)

## 4.3 IRQ Sticky (Section D)

// Rising edge detect (Verilog 2001 pattern)

reg ascon_irq_prev;

always @(posedge clk) ascon_irq_prev <= ascon_irq;

wire ascon_irq_rising = ascon_irq & ~ascon_irq_prev;

// Sticky set / W1C clear

if (irq_w1c_clear) irq_status_r <= 0;

else if (ascon_irq_rising) irq_status_r <= 1;

# 5. Yêu Cầu Hành Vi (Behavioral Requirements)

# | Yêu Cầu | Chi Tiết

B1 | AXI4-Lite handshake | AWVALID+AWREADY → WVALID+WREADY → BVALID+BREADY. Thứ tự AW/W có thể đảo.
B2 | Read handshake | ARVALID+ARREADY → RVALID+RREADY. RLAST luôn = 1'b1.
B3 | BVALID timing | Chỉ assert sau khi cả AW lẫn W channel đều hoàn thành handshake.
B4 | ID echo | BID = latched AWID; RID = latched ARID.
B5 | BRESP – SLVERR | BRESP = 2'b10 nếu ghi vào RO register (SYS_ID, ICACHE_*, DCACHE_*, CYCLE_CNT). OKAY cho tất cả còn lại.
B6 | BRESP – OKAY reserved | Ghi vào địa chỉ reserved (0x028–0xFFF) trả OKAY, bị ignore.
B7 | RRESP | RRESP = 2'b00 (OKAY) cho mọi địa chỉ kể cả reserved.
B8 | SYS_CTRL soft_rst | Ghi 1 vào bit[0]: assert soft_rst_pulse 1 cycle, tự clear sau đó. Đọc SYS_CTRL luôn trả 0.
B9 | IRQ_STATUS sticky | Set khi rising edge ascon_irq; clear khi CPU ghi 1 vào bit[0] (W1C).
B10 | IRQ_MASK | Bit[0]=1 enable ascon_irq; =0 masked. Không ảnh hưởng việc set sticky.
B11 | CYCLE_CNT | Tăng 1 mỗi cycle. Reset về 0 khi rst_n=0 hoặc soft_rst_pulse=1.
B12 | Verilog 2001 only | KHÔNG dùng SystemVerilog: logic, always_ff, always_comb, $past, interface.

# 6. Cách Tích Hợp vào soc_top.v

Tìm comment // [9] SoC Ctrl Stub trong soc_top.v và thay bằng instantiation sau. Sau đó xóa toàn bộ assign s3_* DECERR stub bên dưới.

// [9] SoC Ctrl Slave (thay thế stub DECERR)

`include "soc_ctrl_slave.v"

soc_ctrl_slave #(

.ADDR_WIDTH (AXI_ADDR_WIDTH),

.DATA_WIDTH (AXI_DATA_WIDTH),

.ID_WIDTH (AXI_ID_WIDTH)

) u_ctrl (

.clk (clk),

.rst_n (rst_n),

.S_AXI_AWID (s3_awid),

.S_AXI_AWADDR (s3_awaddr),

.S_AXI_AWLEN (s3_awlen),

.S_AXI_AWSIZE (s3_awsize),

.S_AXI_AWBURST (s3_awburst),

.S_AXI_AWPROT (s3_awprot),

.S_AXI_AWVALID (s3_awvalid),

.S_AXI_AWREADY (s3_awready),

.S_AXI_WDATA (s3_wdata),

.S_AXI_WSTRB (s3_wstrb),

.S_AXI_WLAST (s3_wlast),

.S_AXI_WVALID (s3_wvalid),

.S_AXI_WREADY (s3_wready),

.S_AXI_BID (s3_bid),

.S_AXI_BRESP (s3_bresp),

.S_AXI_BVALID (s3_bvalid),

.S_AXI_BREADY (s3_bready),

.S_AXI_ARID (s3_arid),

.S_AXI_ARADDR (s3_araddr),

.S_AXI_ARLEN (s3_arlen),

.S_AXI_ARSIZE (s3_arsize),

.S_AXI_ARBURST (s3_arburst),

.S_AXI_ARPROT (s3_arprot),

.S_AXI_ARVALID (s3_arvalid),

.S_AXI_ARREADY (s3_arready),

.S_AXI_RID (s3_rid),

.S_AXI_RDATA (s3_rdata),

.S_AXI_RRESP (s3_rresp),

.S_AXI_RLAST (s3_rlast),

.S_AXI_RVALID (s3_rvalid),

.S_AXI_RREADY (s3_rready),

.icache_hits (icache_hits),

.icache_misses (icache_misses),

.dcache_hits (dcache_hits),

.dcache_misses (dcache_misses),

.dcache_writes (dcache_writes),

.ascon_irq (ascon_irq)

);

# 7. Verification Checklist

Sau khi thêm soc_ctrl_slave vào SoC, chạy simulation (iverilog -o out.vvp run_soc.v && vvp out.vvp) và kiểm tra:

# | Kiểm Tra | Kỳ Vọng | Signal Path

✓1 | S3 access count | > 0 | Testbench report section (4): S3 accesses
✓2 | DECERR count | = 0 | Testbench report: DECERR events
✓3 | CPU return code | a0 = 0 (OK) | soc.cpu.reg_file[10] hoặc register dump
✓4 | ASCON S2 accesses | > 0 | Testbench report: S2 accesses
✓5 | SYS_ID read | 0xASC0_0001 | soc.u_ctrl.reg_sys_id (hoặc read via firmware)
✓6 | CYCLE_CNT | Tăng dần | soc.u_ctrl.cycle_cnt_r
✓7 | IRQ_STATUS sticky | Set sau ascon_irq rising | soc.u_ctrl.irq_status_r
✓8 | DMA done (nếu dùng) | STATUS.DMA_DONE=1 | soc.u_ascon_ip.u_slave.status_word[3]

# 8. Quy Tắc Verilog 2001 (Bắt Buộc)

⚠ Tất cả module trong project PHẢI tuân thủ Verilog IEEE 1364-2001. Icarus Verilog chạy ở mode default (không phải SystemVerilog).

Loại | ✓ Được phép | ✗ Cấm
Language | Verilog 2001 | SystemVerilog: logic, always_ff, always_comb, interface
Edge detect | reg prev; always @(posedge clk) prev <= sig; | $past() — không tồn tại trong Verilog
Reset | always @(posedge clk or negedge rst_n) | always_ff @(posedge clk, negedge rst_n)
Assign | assign, always @(*) | always_comb, always_latch
Data type | wire, reg, integer | logic, bit, byte, shortint
Include | `include "file.v" | import package::*

# Phụ Lục – Lệnh Simulation Nhanh

# Compile + simulate

iverilog -g2001 -Wall -o sim.vvp run_soc.v

vvp sim.vvp

# Xem waveform

gtkwave dump.vcd &

# Signal taps quan trọng cho u_ctrl:

# soc.u_ctrl.cycle_cnt_r

# soc.u_ctrl.irq_status_r

# soc.u_ctrl.irq_mask_r

# soc.u_ctrl.soft_rst_pending

— Hết tài liệu —

RISC-V + ASCON SoC v3 | soc_ctrl_slave Module Specification
