ChiThang12/Design_SoC_RISCV_ASCON/survey/Bảng so sánh RISC-V core-platform-fabricated.xlsx

Sheet: Cores
Tên Core | Nhà Phát Triển / License | Ngôn Ngữ HDL | ISA Hỗ Trợ | Pipeline | Tính Năng Nổi Bật | Hiệu Năng Benchmark | Tần Số Đạt Được | Tài Nguyên FPGA / Silicon | Ứng Dụng Điển Hình | Ưu Điểm | Hạn Chế | Link
Ibex | lowRISC / Apache 2.0 | SystemVerilog | RV32I[M]C / RV32E[M]C | Cấu trúc 2 tầng (stage) hoặc 3 tầng | Hỗ trợ bảo mật phần cứng (Memory Protection, Physical Memory Protection - PMP), các tính năng chống tấn công kênh bên (Side-channel mitigation), Dummy Instruction Insertion. | Đạt xấp xỉ 2.33 CoreMark/MHz và 1.21 DMIPS/MHz (khi sử dụng cấu hình tối ưu). | Phụ thuộc vào công nghệ: Khoảng 100-200 MHz trên FPGA (Xilinx Artix-7) và có thể lên tới 500MHz - 1GHz trên tiến trình ASIC 28nm | Cấu hình nhỏ nhất (RV32EC) tốn khoảng ~15k Gates (ASIC) hoặc ~1.5k LUTs (FPGA). Cấu hình đầy đủ khoảng ~60k-80k Gates. | Vi điều khiển IoT, Hệ thống nhúng | Mã nguồn mở hoàn toàn, có thể tinh gọn cấu hình RV32E, tập lệnh bảo mật. | Chỉ hỗ trợ 32-bit pipeline ngắn | https://github.com/lowRISC/ibex
PicoRV32 | Clifford Wolf / ISC | Verilog | RV32I/E[MC], Có hỗ trợ cấu hình RV32E (giảm xuống 16 thanh ghi). | Không có Pipeline (Non-pipelined). Kiến trúc hoạt động theo dạng máy trạng thái đa chu kỳ (Multi-cycle state machine), mất khoảng 4-5 chu kỳ đồng hồ (CPI) để hoàn thành một lệnh. | Hỗ trợ giao diện AXI4-Lite gốc (module picorv32_axi), tích hợp Giao diện Bộ đồng xử lý (PCPI - Pico Co-Processor Interface) cho phép gắn thêm các bộ tăng tốc phần cứng tùy chỉnh, hỗ trợ Ngắt (IRQ). | Khoảng 0.516 DMIPS/MHz (đối với bài test Dhrystone). Chỉ số CPI trung bình (Cycles Per Instruction) dao động từ 4 đến 5 tùy thuộc vào tập lệnh. | Tần số rất cao do không có đường dẫn logic dài: Lên tới 250 - 400 MHz trên FPGA Xilinx 7-Series và có thể đạt ~750 MHz trên các tiến trình ASIC tiêu chuẩn. | Cực kỳ nhỏ: Tốn khoảng 750 đến 2000 LUTs trên FPGA Xilinx 7-Series (tùy thuộc vào việc có bật AXI4, khối nhân chia và ngắt) | Làm bộ vi điều khiển phụ trợ (Auxiliary processor) trong các SoC lớn, chip nhúng IoT | Mã nguồn Verilog 1 file cực kỳ dễ đọc, hiểu và tích hợp. Rất tiết kiệm tài nguyên. Có giao diện PCPI cực kỳ tiện lợi để gắn thêm các bộ xử lý custom (như bộ giải mã). Tương thích sẵn với bus AXI4. | Hiệu năng tính toán (IPC) thấp do không có pipeline. Không hỗ trợ các tính năng bảo mật bộ nhớ (PMP) hoặc các cấp độ đặc quyền phức tạp để chạy hệ điều hành như Linux. | https://github.com/cliffordwolf/picorv32
VexRiscv | SpinalHDL / MIT | SpinalHDL | RV32I[M][A][F][D][C]. Cho phép người dùng tự do cấu hình bật/tắt từng tập lệnh mở rộng. | Cấu trúc 5 tầng (5-stages): Fetch -> Decode -> Execute -> Memory -> Writeback. | Kiến trúc Plugin (Plugin-based): CPU không phải là một khối liền mạch mà được ghép lại từ nhiều Plugin nhỏ (Ví dụ: IntAluPlugin, MulPlugin, CsrPlugin). Hỗ trợ Caches (Instruction/Data), MMU, PMP, JTAG Debug và tương thích nhiều Bus (AXI4, Avalon, Wishbone). | Rất cao đối với kiến trúc 32-bit: 1.44 CoreMark/MHz và 1.25 DMIPS/MHz (khi bật full cấu hình và bộ nhớ đệm). | nhờ pipeline 5 tầng: Có thể đạt trên 400 MHz trên FPGA Xilinx Artix-7 (tốc độ cao nhất trong số các core mã nguồn mở) và dễ dàng vượt mức 1 GHz trên ASIC. | - Cấu hình nhỏ nhất (chỉ RV32I): ~500 LUTs / Registers. - Cấu hình đầy đủ chạy Linux (có Caches, MMU): ~3000 đến 4000 LUTs. | Từ vi điều khiển nhúng siêu nhỏ cho đến SoC lõi đa nhân (Multi-core) chạy hệ điều hành Linux/FreeRTOS. Phù hợp cho các dự án cần tích hợp bộ tăng tốc AI hoặc mã hóa (Crypto). | chèn thêm lệnh phần cứng tùy chỉnh (Custom Instructions) trực tiếp vào ALU mà không cần viết lại toàn bộ core. Sinh ra mã Verilog rất gọn gàng và tối ưu tài nguyên. |  | https://github.com/SpinalHDL/VexRiscv
CV32E40P | OpenHW Group | SystemVerilog | RV32IM[F]C (Tùy chọn bật/tắt khối Floating Point - F) kết hợp cùng tập lệnh mở rộng Xcorev (Core-V eXtensions) chuyên biệt cho DSP. | Cấu trúc 4 tầng (4-stages): Instruction Fetch (IF) -> Instruction Decode (ID) -> Execute (EX) -> Writeback (WB). | Vòng lặp phần cứng (Hardware Loops) cho phép chạy vòng lặp không tốn chu kỳ trễ. Hỗ trợ các lệnh tính toán nhân cộng tích lũy (MAC), Post-increment load/store. Giao tiếp bộ nhớ qua chuẩn bus OBI (Open Bus Interface). | Đạt xấp xỉ 3.16 CoreMark/MHz | Tối ưu rất tốt cho ASIC, có thể đạt trên 600 MHz ở tiến trình 28nm. Trên môi trường mô phỏng FPGA thông thường, tốc độ dao động khoảng 50 - 100 MHz. | Kích thước thuộc dạng trung bình khá (Mid-size). Tốn khoảng 40k - 50k Logic Gates trên ASIC (không có FPU), và lên tới ~70k Gates nếu bật FPU. Tương đương khoảng 4000 - 6000 LUTs trên FPGA. | Lý tưởng cho các thiết bị IoT yêu cầu hiệu năng tính toán cao, xử lý tín hiệu số (DSP), Machine Learning tại biên (Edge AI) và điều khiển động cơ. | Hiệu suất tính toán (IPC) vượt trội nhờ tập lệnh mở rộng Xcorev. Được xác minh và kiểm thử ở cấp độ công nghiệp (Industrial-grade verification) bởi OpenHW Group, đảm bảo độ tin cậy và không có lỗi phần cứng tiềm ẩn. | Mã nguồn phức tạp, khó can thiệp thay đổi đối với dự án sinh viên. Phải sử dụng bộ trình biên dịch riêng (corev-gcc) để tận dụng hết các tập lệnh mở rộng thay vì GCC chuẩn. Việc giao tiếp bằng bus OBI đòi hỏi phải viết thêm cầu nối (bridge) nếu muốn dùng với bus AXI4. | https://github.com/openhwgroup/cv32e40p
SERV | Olof Kindgren/ISC License | Verilog | RV32I / RV32E. Hỗ trợ tùy chọn thêm các tập lệnh Nén [C], Nhân chia [M] và [Zicsr] thông qua các tham số cấu hình. | Kiến trúc Bit-Serial (Nối tiếp từng bit). Không dùng pipeline truyền thống. Nó xử lý 1 lệnh 32-bit bằng cách tính toán lần lượt từng bit một qua ALU 1-bit, mất từ 32 chu kỳ đồng hồ (clock cycles) trở lên cho một lệnh. | Lõi RISC-V nhỏ, Có đi kèm nền tảng SoC mẫu tên là Servant và tương thích hệ sinh thái quản lý gói FuseSoC. | Hiệu năng IPC (Lệnh/Chu kỳ) cực kỳ thấp (khoảng ~0.04 CoreMark/MHz) do định hướng đánh đổi hoàn toàn tốc độ lấy diện tích nhỏ nhất có thể. | Tần số tối đa (Fmax) rất cao vì đường dẫn logic cực ngắn (logic depth nhỏ). Dễ dàng chạy ở mức hàng trăm MHz trên các dòng FPGA thông thường. | Kích thước kỷ lục siêu nhỏ: Tốn chưa tới 200 LUTs (Cụ thể khoảng 198 LUTs trên dòng FPGA Lattice iCE40). | Dùng để thay thế các máy trạng thái (FSM) phức tạp, vi điều khiển cho cảm biến (Sensor Hub), các hệ thống nhúng IoT | Tiết kiệm tài nguyên Code Verilog gọn nhẹ, dễ bảo trì, dễ port lên mọi loại FPGA (như dòng iCE40). Có sẵn thư viện testbench (verilator) và công cụ tự động hóa | Tốc độ xử lý siêu chậm do phải tốn ít nhất 32 xung nhịp để xử lý xong 1 lệnh cơ bản. Hoàn toàn không phù hợp cho các tác vụ cần hiệu năng tính toán cao hoặc xử lý dữ liệu liên tục. | https://github.com/olofk/serv
NEORV32 | Stephan Nolting / license BSD 3-Clause | VHDL (VHDL-93) | RV32I[E][M][A][C][B][K][U][X][Zicsr][Zifencei][Zmmul][Zfinx][Zxcfu]. Hỗ trợ cả tập lệnh mã hóa Scalar Cryptography [K]. | Cấu trúc 2 tầng (2-stages): Fetch và Execute. Đây là thiết kế tối giản để giảm thiểu tài nguyên và độ phức tạp của logic điều khiển. | Là một Processor-system-on-chip hoàn chỉnh: Tích hợp sẵn Bootloader, UART, SPI, TWI, PWM, Timer, Watchdog, và khối CFS (Custom Functions Subsystem) để người dùng tự chèn logic riêng. | Đạt khoảng 2.50 CoreMark/MHz và xấp xỉ 1.2 DMIPS/MHz. | Khoảng 100-120 MHz trên FPGA phổ thông (Artix-7). Có thể cao hơn nếu chỉ tổng hợp CPU lõi mà không kèm ngoại vi. | Cấu hình CPU tối thiểu: ~1100 LUTs. - Cấu hình SoC đầy đủ (với ngoại vi): ~2000 đến 3000 LUTs trên dòng Xilinx 7-series. | Thay thế các vi điều khiển 8/16-bit, điều khiển hệ thống nhúng trên FPGA, các nút cảm biến IoT hoặc làm SoC học thuật. | Dễ thiết lập (chỉ cần chạy make), không phụ thuộc vào các công cụ EDA . Đi kèm bộ thư viện C (Software framework) tốt. | Viết bằng VHDL nên có thể không thuận tiện,Pipeline ngắn nên không đạt được xung nhịp siêu cao như các thiết kế 5 tầng (như VexRiscv). | https://github.com/stnolting/neorv32
SweRV EH1 | Western Digital (WD)//Apache 2.0 | SystemVerilog | RV32IMC (Tập lệnh cơ sở 32-bit, Nhân chia [M], Nén lệnh [C] và các thanh ghi hệ thống Zicsr/Zifencei). | Cấu trúc cực kỳ mạnh mẽ: 9 tầng (9-stages), kiến trúc Phát hành kép (Dual-issue superscalar), thực thi theo thứ tự (In-order execution). | Có thể xử lý 2 lệnh cùng lúc trên 1 xung nhịp. Tích hợp bộ dự đoán phân nhánh (Branch Predictor) tiên tiến. Có bộ nhớ truy xuất cực nhanh: ICCM (cho lệnh) và DCCM (cho dữ liệu). Tích hợp sẵn bộ điều khiển ngắt khả trình (PIC). Hỗ trợ bus AXI4 và AHB-Lite. | Xấp xỉ 4.9 CoreMark/MHz | Thiết kế nhắm thẳng vào ASIC hiệu năng cao, có thể đạt tốc độ hơn 1 GHz trên tiến trình TSMC 28nm. Trên FPGA, tốc độ bị giới hạn nhiều bởi kiến trúc pipeline sâu và phức tạp. | Kích thước rất lớn (Heavy-weight). Do là kiến trúc Superscalar 9 tầng, nó tiêu tốn diện tích silicon và tài nguyên logic (LUTs/Registers) lớn hơn rất nhiều lần so với các lõi như VexRiscv hay NEORV32. | Các ứng dụng biên yêu cầu tính toán, chip vi điều khiển cho ổ cứng SSD (Western Digital phát triển lõi này để dùng trong chính ổ cứng của họ), xử lý tín hiệu mạng và thiết bị lưu trữ. | Hiệu suất IPC (số lệnh trên một chu kỳ). Mã nguồn được kiểm thử ở cấp độ thương mại/công nghiệp (Industrial-grade), có độ tin cậy | Kiến trúc Dual-issue khiến việc tự mod thêm các lệnh phần cứng (Custom Instructions) khó. Yêu cầu công cụ tổng hợp SystemVerilog mạnh | https://github.com/chipsalliance/Cores-VeeR-EH1
rocket
BOOM
CVA6

Sheet: SoC Platforms
Tên nền tảng (Platform) | Nhà phát triển / License | Ngôn ngữ HDL / Framework | Cores hỗ trợ | Kiến trúc hệ thống | Ngoại vi tích hợp | Hỗ trợ bộ nhớ | Khả năng chạy OS | Tài nguyên FPGA / Silicon | Ứng dụng điển hình | Ưu điểm | Hạn chế | Link
Rocket Chip | UC Berkeley BAR, SiFive / BSD | Chisel, Scala | Rocket | TileLink-based SoC generator, cache-coherent multicore | UART, SPI, GPIO, Interrupt controller, Debug module | SRAM, DDR via controller, cache hierarchy | Linux, RTOS, Bare-metal | Trung bình đến lớn; phù hợp FPGA Xilinx/ASIC | Nghiên cứu CPU, Linux-capable SoC, ASIC prototyping | Highly-parameterized, ecosystem mạnh, nền tảng của Chipyard | Chisel learning curve cao | https://github.com/chipsalliance/rocket-chip, https://chipyard.readthedocs.io
lowRISC | lowRISC / BSD | Verilog, Chisel | RV32IM | SoC đơn nhân đơn giản hướng open-source silicon | UART, GPIO, Timer, SPI | SRAM, external DRAM | RTOS, Bare-metal | Nhẹ đến trung bình | Giáo dục, embedded SoC | Thiết kế đơn giản, dễ nghiên cứu | Không mạnh cho Linux/full SMP | https://github.com/lowRISC/lowrisc-chip, https://www.lowrisc.org
PULPino | ETH Zurich, Univ. Bologna / Solderpad | SystemVerilog | RI5CY, Zero-riscy | MCU-style SoC tiết kiệm năng lượng | UART, SPI, I2C, GPIO, Timer, DMA | Tightly coupled memory, SRAM | Bare-metal, FreeRTOS | Rất nhẹ | IoT, ultra-low-power MCU | Power efficiency rất tốt | Không hỗ trợ Linux/MMU | https://github.com/pulp-platform/pulpino, https://pulp-platform.org
PULPissimo | ETH Zurich, Univ. Bologna / Solderpad | SystemVerilog | RI5CY, Zero-riscy | Single-core microcontroller SoC | uDMA, SPI, I2C, I2S, UART, GPIO, Camera interface | L2 SRAM, external HyperBus | RTOS, Bare-metal | Nhẹ | Edge AI, sensor processing | Peripheral subsystem mạnh | Không tối ưu cho high-performance Linux | https://github.com/pulp-platform/pulpissimo, https://pulp-platform.org
Ariane SoC | ETH Zurich / Solderpad | SystemVerilog | Ariane (CVA6) | 64-bit Linux-capable SoC | UART, Ethernet, Timer, Debug | DDR/AXI memory subsystem | Linux, RTOS | Trung bình đến lớn | Linux-capable FPGA SoC | RV64GC + MMU hoàn chỉnh | Hiệu năng thấp hơn commercial high-end cores | https://github.com/openhwgroup/cva6, https://cva6.readthedocs.io
OpenPULP | ETH Zurich, Univ. Bologna / Solderpad | SystemVerilog | RI5CY cluster | Manycore ultra-low-power platform | DMA, GPIO, camera/audio interfaces | Scratchpad + shared L2 | RTOS, runtime frameworks | Trung bình | Parallel DSP, AI accelerator research | Heterogeneous multicore mạnh | Lập trình phức tạp | https://github.com/pulp-platform, https://pulp-platform.org
HERO | ETH Zurich / Solderpad | SystemVerilog + FPGA integration | RI5CY clusters | Heterogeneous CPU + FPGA accelerator platform | Accelerator interfaces, DMA | Shared memory, FPGA memory hierarchy | Linux host + accelerator runtime | FPGA-intensive | HPC acceleration, heterogeneous computing | CPU-FPGA integration tốt | Triển khai phức tạp | https://github.com/pulp-platform/hero
OpenPiton + Ariane | Princeton + ETH Zurich / BSD + Solderpad | Verilog, SystemVerilog | Ariane/CVA6 | Manycore cache-coherent tiled architecture | NoC, Debug, Ethernet | Shared memory, DDR | Linux SMP | Lớn; yêu cầu FPGA cao cấp hoặc ASIC | Manycore research, datacenter-scale RISC-V | Scalability rất cao | Build/runtime phức tạp | https://github.com/PrincetonUniversity/openpiton
Briey | SpinalHDL community / MIT | SpinalHDL (Scala) | VexRiscv | Lightweight FPGA SoC | UART, VGA, GPIO, Timer | SDRAM/BRAM | RTOS, Bare-metal, limited Linux experiments | Rất nhẹ | FPGA demo, education | Dễ synthesize, nhanh trên FPGA nhỏ | Tính năng hạn chế | https://github.com/SpinalHDL/VexRiscv, https://spinalhdl.github.io/SpinalDoc-RTD/
Riscy | Aleksandar Kostovic / MIT | Verilog | RV64I | Simple RV64 SoC | UART, Timer | SRAM | Bare-metal | Nhẹ | Giáo dục kiến trúc máy tính | Dễ hiểu, tối giản | Không có MMU/peripheral phong phú | https://github.com/AleksandarKostovic/Riscy-SoC
Raven | Efabless / ISC | Verilog | PicoRV32 | Tiny SoC for Open MPW shuttles | GPIO, UART, logic analyzer interface | SRAM | Bare-metal | Rất nhỏ | Open-source silicon tapeout | Dễ tapeout qua Sky130 | Hiệu năng hạn chế | https://github.com/efabless/raven-picorv32
PicoSoC | Clifford Wolf / ISC | Verilog | PicoRV32 | Minimal SoC | UART, SPI Flash interface, GPIO | SRAM, SPI Flash XIP | Bare-metal | Cực nhẹ | FPGA nhỏ, bootloader, MCU | Tiny footprint | Không hỗ trợ OS phức tạp | https://github.com/cliffordwolf/picorv32
Icicle | Graham Edgecombe / ISC | Verilog | RV32I | Small FPGA-oriented SoC | UART, Timer | BRAM | Bare-metal | Rất nhẹ | FPGA learning platform | Thiết kế đơn giản | Tính năng ít | https://github.com/grahamedgecombe/icicle
MIV RV32IMA L1 AHB | Microchip / Apache 2.0 | Verilog | Rocket RV32IMA | AMBA AHB-based subsystem | UART, SPI, GPIO, Timer | SRAM, external memory | RTOS, Bare-metal | Trung bình | PolarFire FPGA SoC | Toolchain và ecosystem tốt | Gắn với Microchip ecosystem | https://github.com/polarfire-soc
MIV RV32IMA L1 AXI | Microchip / Apache 2.0 | Verilog | Rocket RV32IMA | AXI interconnect-based SoC | UART, SPI, GPIO | SRAM, AXI memory | RTOS, Bare-metal | Trung bình | FPGA embedded system | AXI compatibility tốt | Không hướng Linux | https://github.com/polarfire-soc
MIV RV32IMAF L1 AHB | Microchip / Apache 2.0 | Verilog | Rocket RV32IMAF | Floating-point embedded SoC | UART, SPI, GPIO, Timer | SRAM, external memory | RTOS, Bare-metal | Trung bình | DSP/control embedded applications | Hỗ trợ floating-point | Linux support hạn chế | https://github.com/polarfire-soc
MIV RV32IMC | Microchip / Apache 2.0 | Verilog | Submicron RV32I/RV32IC/RV32IM/RV32IMC | Compact MCU SoC | UART, SPI, GPIO | SRAM | Bare-metal, RTOS | Nhẹ | Low-cost MCU FPGA systems | Compressed ISA support | Hiệu năng thấp | https://github.com/polarfire-soc
FreeStart AE250 | Andes / Evaluation License | Verilog | Andes N22 | Entry-level evaluation SoC | UART, GPIO, SPI, Timer | SRAM, external memory | RTOS, Bare-metal | Nhẹ | Andes evaluation platform | Dễ đánh giá Andes ecosystem | License giới hạn evaluation | https://github.com/andestech
Standard AE250 | Andes / Commercial | Verilog | Andes N22 | Commercial embedded SoC | UART, SPI, I2C, GPIO | SRAM, DDR | RTOS | Trung bình | Industrial embedded systems | Commercial support tốt | Không open-source | https://github.com/andestech, https://www.andestech.com
AE350 | Andes / Commercial | Verilog | N25F, D25F, A25, A25MP, NX25, AX25, AX25MP, A27, A27L2, AX27, AX27L2, N45, D45, A45, NX45, AX45 | High-performance configurable multicore SoC | Ethernet, PCIe, DMA, USB, UART | DDR3/DDR4, cache hierarchy | Linux, RTOS | Trung bình đến lớn | Linux-capable industrial SoC | Scalability cao | Ecosystem đóng | https://github.com/andestech
SCR1 SDK | Syntacore / SHL 2.0 | Verilog | SCR1, SCRx | Compact MCU-class SoC SDK | UART, SPI, GPIO, Timer | SRAM | RTOS, Bare-metal | Nhẹ | Embedded firmware development | SDK/toolchain mạnh | Không hỗ trợ Linux đầy đủ | https://github.com/syntacore/scr1
ESP | Columbia University SLD / Apache 2.0 | SystemVerilog, Chisel | Ariane | Accelerator-centric heterogeneous SoC | Accelerator tiles, DMA, Ethernet | DDR memory subsystem | Linux + accelerator runtime | Lớn | Domain-specific acceleration research | Tích hợp accelerator mạnh | Build flow phức tạp | https://github.com/sld-columbia/esp, https://www.esp.cs.columbia.edu
Chipyard | UC Berkeley BAR / BSD | Chisel, Scala | Rocket, BOOM, CVA6, others | Full SoC integration framework | UART, SPI, Ethernet, PCIe (optional) | DDR, cache hierarchy | Linux, RTOS, Bare-metal | Trung bình đến rất lớn | ASIC prototyping, academic SoC research | Ecosystem mạnh nhất RISC-V open-source | Setup nặng, compile lâu | https://github.com/ucb-bar/chipyard, https://chipyard.readthedocs.io
PQSoC | PQShield / Commercial | Verilog | Pluto | Security-oriented SoC | Crypto accelerators, secure peripherals | SRAM, secure memory | RTOS, Bare-metal | Nhẹ đến trung bình | Post-quantum cryptography | Hardware security integration | Không fully open-source | https://github.com/pqshield, https://pqshield.com
KRZ | Sonal Pinto / Apache 2.0 | Verilog | Kronos | Lightweight SoC around Kronos core | UART, GPIO, Timer | SRAM | Bare-metal | Nhẹ | Educational SoC | Đơn giản, dễ modify | Ecosystem nhỏ | https://github.com/SonalPinto/kronos
IOb-SoC | IObundle / MIT | Verilog | PicoRV32 | Modular FPGA/ASIC SoC | UART, SPI, Ethernet optional | SRAM, external DDR | RTOS, Bare-metal | Nhẹ | FPGA prototyping | Modular architecture | Hiệu năng hạn chế | https://github.com/IObundle/iob-soc, https://www.iobundle.com
SweRVolf | CHIPS Alliance / Apache 2.0 | Verilog | SweRV EH1, EL2 | Performance-oriented MCU SoC | UART, SPI, GPIO, Debug | SRAM | RTOS, Bare-metal | Trung bình | Real-time embedded | IPC cao cho RV32 | Linux support hạn chế | https://github.com/chipsalliance/Cores-SweRVolf, https://chipsalliance.github.io/Cores-SweRVolf-Docs/
Servant | Olof Kindgren / ISC | Verilog | SERV | Bit-serial minimal SoC | UART, Timer | BRAM/SRAM | Bare-metal | Cực nhỏ | Tiny FPGA, educational | Resource usage cực thấp | Hiệu năng rất thấp | https://github.com/olofk/servant
NEORV32 Processor | Stephan Nolting / BSD | VHDL | NEORV32 | MCU-style configurable processor SoC | UART, SPI, I2C, PWM, GPIO, WDT | Internal IMEM/DMEM, external memory | RTOS, Zephyr, bare-metal | Nhẹ | Industrial FPGA softcore | Documentation rất tốt | Không phù hợp Linux/MMU | https://github.com/stnolting/neorv32, https://stnolting.github.io/neorv32/
GRLIB | Cobham Gaisler / GPL + Commercial | VHDL | NOEL-V | Space-grade SoC framework | SpaceWire, Ethernet, CAN, UART | SRAM, DDR, ECC memory | RTEMS, Linux | Trung bình đến lớn | Aerospace, space systems | Radiation-tolerant ecosystem | Commercial tooling/license phức tạp | https://github.com/TUT-ASI/leon3-grlib-gpl-mirror
LiteX | Enjoy Digital / BSD | Python, Migen, LiteX framework | BlackParrot, CV32E40P, Minerva, PicoRV32, Rocket, SERV, VexRiscv (SMP supported with VexRiscv) | Python-generated modular FPGA SoC | Ethernet, UART, SPI, I2C, SDRAM, Video, PCIe | SDRAM, DDR, HyperRAM, BRAM | Linux, Zephyr, RTOS, bare-metal | Rất linh hoạt; từ FPGA nhỏ đến lớn | FPGA prototyping, custom SoC research | Tích hợp nhanh, hỗ trợ nhiều core, ecosystem mạnh | Hiệu năng phụ thuộc FPGA/toolchain | https://github.com/enjoy-digital/litex, https://github.com/enjoy-digital/litex/wiki
 |  |  |  |  |  |  |  |  |  | Người tạo: | Đặng Văn Rin

Sheet: Fabricated SoCs
Tên SoC | Nhà sản xuất | Công nghệ sản xuất (process node) | Cores tích hợp | Số lượng core | Tần số hoạt động | Bộ nhớ tích hợp | Ngoại vi hỗ trợ | Khả năng chạy OS | Ứng dụng điển hình | Ưu điểm | Hạn chế | Link
FE310-G000 | SiFive | TSMC CL018G 180nm | SiFive E31 RISC-V core | 1 |  | 16 KiB DTIM/data SRAM, 16 KiB instruction cache, 8 KiB Mask ROM, 8 KiB OTP | PLIC/CLINT interrupt, GPIO, UART, QSPI/SPI, PWM, Watchdog, RTC, PMU/AON, JTAG | RTOS | thiết bị IoT đơn giản, điều khiển cảm biến, giao tiếp ngoại vi, lập trình bare-metal và RTOS nhỏ. | Dùng kiến trúc RISC-V mở; tích hợp GPIO, UART, SPI, PWM, timer, watchdog, RTC; hỗ trợ QSPI execute-in-place và debug JTAG | RAM nhỏ, chỉ hỗ trợ Machine mode, không phù hợp chạy Linux/OS lớn; ngoại vi còn cơ bản, không có USB, Ethernet, GPU; không phù hợp xử lí nặng. | chrome-extension://kdpelmjpfafjppnhbloffcjpeomlnpah/https://static.dev.sifive.com/FE310-G000.pdf
FE310-G002 | SiFive | TSMC CL018G 180nm | SiFive E31 Core Complex | 1 | Tối đa 320 MHz | 8 KiB OTP, 8 KiB Mask ROM, 16 KiB Instruction Cache, 16 KiB Data SRAM | GPIO 32 chân, UART0/UART1, QSPI0, SPI1/SPI2, PWM0/PWM1/PWM2, I²C0, PLIC, CLINT, watchdog, RTC, AON/PMU, JTAG debug. | RTOS | IoT đơn giản, edge computing nhỏ, điều khiển cảm biến/thiết bị ngoại vi, lập trình bare-metal hoặc RTOS nhỏ. | RISC-V mở; core E31 RV32IMAC; tối đa 320 MHz; có GPIO, UART, SPI/QSPI, I²C, PWM, timer, watchdog, RTC, JTAG debug; hỗ trợ QSPI Flash. | RAM nhỏ 16 KiB; không phù hợp Linux/OS lớn; không có USB, Ethernet, GPU; không phù hợp xử lí AI, ảnh, multimedia; phụ thuộc flash ngoài cho chương trình lớn. | https://www.sifive.com/document-file/freedom-e310-g002-datasheet
FreeDom U540 | SiFive | TSMC 28HPC, 28 nm | U54 (4 cores), E51 (1management core) | 5 core, cấu hình 4+1 | Lên đến khoảng 1.5 GHz | L1 cache riêng cho từng core; L2 cache dùng chung 2 MiB; hỗ trợ DDR3/DDR4 ngoài | DDR3/DDR4 controller, 3 QSPI, 2 UART, I²C, 2 PWM, GPIO, Gigabit Ethernet MAC, ChipLink, PLIC, CLINT, JTAG debug | Linux | Board HiFive Unleashed, phát triển Linux/RISC-V, gateway, edge device, nghiên cứu SoC đa nhân | RISC-V 64-bit đa nhân; hỗ trợ Linux; có Supervisor mode/Sv39; có DDR, Ethernet, cache L2 2 MiB; phù hợp phát triển phần mềm hệ thốn | Không có GPU, USB, display/camera controller tích hợp; cần DDR ngoài; không phù hợp multimedia/AI nặng; chủ yếu là nền tảng phát triển/nhúng Linux | https://www.sifive.com/document-file/freedom-u540-c000-manual
GAP8 | GreenWaves Technologies | TSMC 55 nm LP CMOS | 1 RISC-V Fabric Controller + 8 RISC-V compute cores + HWCE | 9 RISC-V cores | Tối đa khoảng 250 MHz | 512 KiB L2 SRAM; 64 KiB L1 cluster TCDM; 16 KiB L1 FC; 16 KiB shared instruction cache cho cluster; 4 KiB instruction cache cho FC | GPIO, UART, I²C, I²S, SPI/QSPI, SPI slave, CPI camera interface, HyperBus, LVDS, PWM, RTC, JTAG, DMA/uDMA | RTOS | AIoT, xử lí ảnh/âm thanh/cảm biến biên, nhận diện hình ảnh nhỏ, keyword spotting, machine monitoring, camera thông minh công suất thấp | Siêu tiết kiệm năng lượng; có 8-core cluster cho xử lí song song; có HWCE tăng tốc CNN; bộ nhớ L2 512 KiB khá lớn cho MCU AI; nhiều giao tiếp cảm biến/camera | RAM vẫn nhỏ so với application processor; không có MMU/Linux; lập trình song song phức tạp; không phù hợp AI lớn, multimedia nặng hoặc ứng dụng cần OS đầy đủ | https://gwt-website-files.s3.amazonaws.com/gap8_datasheet.pdf
K210 | Kendryte | TSMC 28 nm | Dual-core RISC-V 64-bit, mỗi core có FPU; tích hợp KPU cho AI và APU cho âm thanh | 2 core CPU | 400 MHz | 8 MiB SRAM on-chip; mỗi core có 32 KiB I-cache; có OTP | FPIOA, GPIO, UART, SPI/QSPI, I²C, I²S, WDT, Timer, RTC, AES, SHA256, camera/DVP, LCD interface, microphone array | Linux | AIoT, camera AI nhỏ, nhận diện hình ảnh, nhận diện giọng nói, smart home, smart meter, edge AI công suất thấp | Có KPU tăng tốc neural network; RAM on-chip 8 MiB khá lớn so với MCU; CPU RISC-V 64-bit dual-core 400 MHz; nhiều ngoại vi cho camera, LCD, âm thanh và cảm biến | RAM vẫn nhỏ cho OS lớn; KPU chỉ hợp mô hình nhỏ/đã tối ưu; không có GPU/Ethernet/USB tốc độ cao tích hợp; hệ sinh thái phần mềm hẹp hơn SoC phổ thông | https://www.kendryte.com/en/proDetail/210
RV32M1 | NXP | Không thấy nêu rõ process node trong datasheet công khai này | 1 RISC-V RI5CY + 1 RISC-V ZERO_RISCY + 1 Arm Cortex-M4F + 1 Arm Cortex-M0+ | 4 core | Tối đa khoảng 72 MHz | Tổng 1.25 MB Flash, 384 KB SRAM; trong đó RI5CY có 1 MiB Flash + 192 KiB SRAM, ZERO_RISCY có 256 KiB Flash + 128 KiB SRAM | GPIO, DMA, Watchdog, CRC, crypto accelerator, ADC, DAC, comparator, timer, PWM, RTC, I²C, UART, SPI, I²S, external memory interface, smart card, USB Full-Speed, uSDHC, radio 2.4 GHz hỗ trợ BLE, Generic FSK, IEEE 802.15.4/Thread | RTOS | Thiết bị IoT không dây, BLE/Thread, cảm biến công suất thấp, board phát triển RV32M1-VEGA, nghiên cứu kết hợp RISC-V và Arm | Có kiến trúc đa nhân dị thể; tích hợp cả RISC-V và Arm; có radio 2.4 GHz; nhiều ngoại vi; bộ nhớ flash/SRAM khá lớn cho MCU; phù hợp IoT không dây | Không phải application processor; không chạy Linux đầy đủ; tần số thấp hơn các SoC mạnh; phần mềm Zephyr hiện không còn maintainer tích cực; chip chủ yếu là nền tảng đánh giá, không phổ biến thương mại | https://github.com/open-isa-org/open-isa.org/blob/master/Reference%20Manual%20and%20Data%20Sheet/RV32M1DS_Rev.1.1.pdf
RavenRV32 | Efabless, hợp tác với X-FAB | X-FAB XH018, 180 nm, 6-metal process | PicoRV32, RISC-V 32-bit | 1 core | Đã bench-test 100 MHz; mô phỏng có thể lên đến khoảng 150 MHz | SRAM 32 × 1024 bit, tức khoảng 4 KiB; hỗ trợ SPI flash ngoài | 16 GPIO, SPI flash interface, UART/simpleuart, 2 ADC, 1 DAC, comparator, over-temperature alarm, 100 kHz RC oscillator, programmable GPIO output functions, programmable GPIO input interrupts | RTOS | MCU RISC-V mã nguồn mở, thiết kế tham chiếu ASIC, học tập/ nghiên cứu chip RISC-V, điều khiển analog-mixed-signal nhỏ, cảm biến đơn giản | Thiết kế SoC RISC-V silicon-validated; mã nguồn mở ở mức top-level; có cả ngoại vi số và analog; phù hợp làm mẫu để clone/customize ASIC | RAM rất nhỏ; chỉ 1 core; không có MMU/Supervisor mode; ngoại vi hạn chế; không phù hợp OS lớn, AI, multimedia hay ứng dụng phức tạp | https://github.com/efabless/raven-picorv32/blob/master/doc/EFX3201RV.v2.pdf
PolarFire SoC | Microchip | Không nêu rõ process node trên trang sản phẩm/datasheet công khai; thuộc dòng non-volatile FPGA | U54 (4 cores), E51 (management core) | 5 | 625 MHz | L2 cache 2 MB, có thể cấu hình làm cache/LIM/scratchpad; FPGA fabric RAM tùy dòng, khoảng 1.8–31.6 Mbits; hỗ trợ DDR ngoài | 2 × Gigabit Ethernet MAC, MMC 5.1, 2 × CAN, QSPI, 2 × SPI, 2 × I²C, 5 × UART, USB 2.0 OTG, GPIO, PCIe Gen2/SerDes tùy phiên bản | Linux | SoC FPGA cho công nghiệp, IoT/IIoT, edge computing, vision/AI edge, gateway, hệ thống cần FPGA + Linux RISC-V | RISC-V 64-bit đa nhân; chạy Linux; có FPGA fabric linh hoạt; tiết kiệm điện; bảo mật tốt; có Ethernet, CAN, USB, PCIe/SerDes tùy dòng | Phức tạp hơn MCU thường; cần tool FPGA/SoC như Libero, SoftConsole; không có GPU; hiệu năng CPU không bằng application processor mạnh; phải dùng DDR ngoài cho Linux | https://www.microchip.com/en-us/products/fpgas-and-plds/system-on-chip-fpgas/polarfire-soc-fpgas
GD32VF103 | GigaDevice | Không thấy nêu rõ process node trong datasheet công khai này | Bumblebee RISC-V 32-bit core, kiến trúc RV32IMAC | 1 | Tối đa 108 MHz | Tối đa 128 KB Flash, 32 KB SRAM | GPIO, EXTI, DMA, ADC 12-bit, DAC 12-bit, timers/PWM, RTC, watchdog, USART/UART, SPI, I²C, I²S, CAN, USB FS, CRC, JTAG/SWD debug | RTOS | MCU RISC-V thay thế nhóm STM32F103, board Longan Nano, điều khiển nhúng, IoT, cảm biến, motor/LED, thiết bị giao tiếp USB/CAN | RISC-V 32-bit mở; tần số 108 MHz; ngoại vi rất đầy đủ cho MCU; có USB FS và CAN; bộ nhớ khá ổn cho vi điều khiển | Không có MMU/Supervisor mode; không chạy Linux; RAM chỉ 32 KB; không có Ethernet/GPU/display/camera; không phù hợp AI/multimedia hay xử lí nặng | https://github.com/riscv-mcu/GD32VF103_DataSheets/blob/master/GD32VF103_Datasheet_Rev_1.0.pdf
CH573 | WCH | Không thấy nêu rõ process node trong datasheet | QingKe RISC-V3A 32-bit, hỗ trợ RV32IMAC, có nhân/chia phần cứng | 1 core | Nhiều mức xung hệ thống, thấp nhất 32 kHz; HSE khuyến nghị 32 MHz; PLL mặc định 480 MHz | 512 KB FlashROM gồm 448 KB CodeFlash, 32 KB DataFlash, 24 KB BootLoader, 8 KB InfoFlash; 18 KB SRAM gồm RAM16K + RAM2K | BLE 4.2, USB 2.0 full-speed host/device, SPI, 4 UART, ADC 12-bit, TouchKey, RTC, Timer/PWM, GPIO, AES-128, nhiệt độ sensor, watchdog, DMA, RF 2.4 GHz | RTOS | Thiết bị BLE/IoT công suất thấp, cảm biến không dây, beacon, USB-BLE bridge, smart home, thiết bị đeo đơn giản | Tích hợp BLE + USB + RISC-V trong một MCU; Flash 512 KB khá lớn; có AES-128, ADC, TouchKey, RTC, PWM; công suất thấp; hỗ trợ OTA | RAM chỉ 18 KB; BLE 4.2 không mới bằng BLE 5.x; không có MMU/Supervisor mode; không chạy Linux; không có Ethernet/GPU/display/camera | https://www.wch.cn/products/CH573.html
CH32V103 | WCH | Không thấy nêu rõ process node trong datasheet công khai này | QingKe / WCH RISC-V3A 32-bit, hỗ trợ RV32IMAC, nhân/chia phần cứng | 1 core | Tối đa 80 MHz | 32 KB hoặc 64 KB Flash; 10 KB hoặc 20 KB SRAM; 128 B vùng cấu hình không mất dữ liệu | GPIO, EXTI, DMA 7 kênh, ADC 12-bit, TouchKey, timer/PWM, RTC, watchdog, USB 2.0 full-speed host/device, I²C, SPI, USART, CRC, RVSWD debug |  | MCU RISC-V đa dụng, thiết bị nhúng, IoT có USB, cảm biến, điều khiển motor/LED, thiết bị công nghiệp/tiêu dùng/medical đơn giản | RISC-V 32-bit mở; có USB host/device; nhiều timer và giao tiếp I²C/SPI/USART; điện áp rộng 2.7–5.5 V; có TouchKey và ADC; package đa dạng | RAM/Flash nhỏ; không chạy Linux; không có BLE, Ethernet, GPU, display/camera; hiệu năng thấp hơn SoC ứng dụng; hệ sinh thái hẹp hơn STM32 | RAM/Flash nhỏ; không chạy Linux; không có BLE, Ethernet, GPU, display/camera; hiệu năng thấp hơn SoC ứng dụng; hệ sinh thái hẹp hơn STM32
MiG-V | HENSOLDT Cyber GmbH | Không công bố rõ trong nguồn công khai | RISC-V 64-bit CV6A, RV64IMAC | Không công bố rõ; nguồn công khai chủ yếu mô tả là một processor/core RISC-V 64-bit | Không công bố rõ | Không công bố rõ Có TRNG bảo mật; | Có TRNG bảo mật; các ngoại vi khác không công bố rõ trong nguồn công khai | TRENTOS | Thiết bị bảo mật cao, IoT/OT an toàn, công nghiệp, quốc phòng, hạ tầng trọng yếu | Bảo mật cao; có logic encryption chống hardware Trojan; dùng RISC-V mở; hướng tới nền tảng phần cứng–phần mềm an toàn với seL4/TRENTOS | Thông tin công khai rất hạn chế; không có datasheet/manual đầy đủ; không rõ process node, tần số, bộ nhớ, ngoại vi; thị trường hạn chế | https://hensoldt-cyber.com/mig-v/
 |  |  |  |  |  |  |  |  |  | Người tạo: | Trần Quốc Sĩ
