ChiThang12/Design_SoC_RISCV_ASCON/ascon/ascon_full_benchmark_comparison.html

ref 128

380 MB/s

opt64 128

520 MB/s

avx512 128

249 MB/s

ref 128a

452 MB/s

HW in SoC

1,000 MB/s

HW standalone

2,000 MB/s

Encrypt Decrypt Hardware

SW ref 128: 380 enc 393 dec. SW opt64 128: 520 enc 533 dec. SW avx512 128: 249 enc 253 dec. SW ref 128a: 452 enc 508 dec. HW SoC: 1000. HW standalone: 2000.

Throughput theo kích thước message — SW opt64 128 vs HW

SW opt64 128 enc SW ref 128a enc HW SoC (1 Gbps) HW standalone (2 Gbps)

opt64 128 tăng từ 111 MB/s ở 16B lên 697 MB/s ở 64KB.

Speedup so với SW ref 128 (baseline = 1×)

HW standalone đạt 5.3x speedup.
