ChiThang12/Design_SoC_RISCV_ASCON/debug/Soc_bug_17032026.md

Phân tích chi tiết từng lỗi
BUG 1 — DMA fetch đọc toàn zeros (nghiêm trọng nhất)
[326] ASCON-IN DATA = 00000000000000000000000000000000
[326]   ptext_0=0x00000000  ptext_1=0x00000000  (from DMA)
[328] M2-AR DMA FETCH addr=0x10000000
Nhưng firmware đã ghi PTEXT tại:
[197] [ST] addr=0x10000000  data=0x48656c6c   ← "Hell"
[199] [ST] addr=0x10000004  data=0x6f210000   ← "o!"
Vấn đề: Các [ST] ở cycle 197/199 là CPU → DCache (write-back). Dòng [ST] trong TB được log khi DCache nhận request, không phải khi DMEM vật lý được ghi. fence w,w trong firmware tại dòng step3 (cycle ~230) đáng lẽ phải flush, nhưng nhìn log thấy DMEM-W commit cho PTEXT không xuất hiện — DCache dirty lines chưa được flush ra DMEM vật lý trước khi DMA fetch. Khả năng cao fence w,w trong DCache implementation của bạn chưa drain đúng hoặc không có handshake với DMA start.

BUG 2 — DMA write burst không tăng địa chỉ
[400] [DMEM-W] addr=0x10000010  data=0x17fab278
[401] [DMEM-W] addr=0x10000010  data=0x45f2e8cf
[405] [DMEM-W] addr=0x10000010  data=0xc54f953f
[406] [DMEM-W] addr=0x10000010  data=0x40f7bbe6
[410] [DMEM-W] addr=0x10000010  data=0xa34b336f
[411] [DMEM-W] addr=0x10000010  data=0x556be3fa
Tất cả 6 beats đều ghi vào cùng địa chỉ 0x10000010. Đây là lỗi trong u_width_conv (width converter 64→32): khi split 1 beat 64-bit thành 2 beat 32-bit, hoặc khi làm burst, awaddr không được increment. Kết quả là DMEM chỉ lưu word cuối cùng (0x556be3fa = TAG_2), phần còn lại bị overwrite.
Kiểm tra lại logic awaddr trong u_width_conv: mỗi beat 32-bit cần awaddr = awaddr_base + beat_idx * 4.

BUG 3 — DMEM snapshot / scoreboard sai
Scoreboard chỉ có 1 entry dù firmware ghi 10+ words vào DMEM. Nguyên nhân là TB block (3b) dùng:
verilogalways @(posedge clk)
    if (s1_awvalid && s1_awready)
        s1_aw_addr_lat <= s1_awaddr;   // chỉ latch 1 lần
```

Khi DCache thực hiện **burst write** (awlen>0), `s1_awaddr` chỉ bắt tay 1 lần (AW channel), nhưng W channel có nhiều beats. `s1_aw_addr_lat` giữ nguyên địa chỉ đầu cho tất cả beats → scoreboard nghĩ tất cả writes đều vào cùng 1 địa chỉ. Lỗi này cũng là lý do DMEM snapshot toàn zeros.

---

### BUG 4 — Firmware kẹt ở poll loop, WATCHDOG timeout
```
[366] CPU đọc STATUS = 0x00000005   (bit0=busy?, bit2=core_done)
[384] ASCON CORE DONE  STATUS=0x00000004
[416] ASCON DMA  DONE  STATUS=0x0000000a
Firmware poll STATUS tại cycle 366 — lúc này core vừa xong (0x4) nhưng DMA chưa done. Firmware check STATUS & 0x08 (DMA_DONE bit3) → chưa set → tiếp tục poll. Đến cycle 416 DMA mới done (STATUS=0x0a = bit1+bit3), nhưng sau đó firmware đọc STATUS mãi thấy 0x5 — DMA_DONE bit bị clear trước firmware kịp đọc, hoặc STATUS register không sticky.
Kiểm tra trong ASCON slave: status_dma_done có phải sticky bit (chỉ clear khi CPU ghi SOFT_RST) không? Nếu nó tự clear sau 1–2 cycle thì firmware poll không kịp.

Tóm tắt ưu tiên sửa
#LỗiSửa ở đâu1DCache chưa flush trước DMA fetchu_dcache: đảm bảo fence w,w drain dirty lines ra DMEM trước khi DMA start2Width conv không increment awaddr trong burstu_width_conv: fix address increment logic3TB scoreboard không track burst addressTB block (3b): thêm beat counter, tăng s1_aw_addr_lat mỗi beat4DMA_DONE không stickyu_ascon slave: status_dma_done phải giữ cho đến SOFT_RST
Lỗi 2 và 4 là lỗi trong RTL của bạn. Lỗi 1 có thể là do lỗi 4 gây ra — nếu DMA_DONE không visible thì firmware không bao giờ thoát poll loop để kiểm tra kết quả, nhưng DMA fetch sai data thì là vấn đề riêng của flush. Lỗi 3 là bug của TB không ảnh hưởng kết quả thực tế nhưng gây khó debug.
