ChiThang12/Design_SoC_RISCV_ASCON/paper2/plan_debug_paper2.md

# Xem `01_baseline_old_arch.md`

File này đã được tách sang tài liệu chuẩn:
- `paper2/01_baseline_old_arch.md`
- `paper2/03_comparison_results.md`

Mục đích là tách rõ:
- baseline kiến trúc cũ
- kế hoạch kiến trúc mới
- số liệu so sánh sau khi triển khai
