ChiThang12/Design_SoC_RISCV_ASCON/debug/Soc_ascon_11032026.md

# Debug Log — RISC-V SoC + ASCON IP Firmware

**Project:** RISC-V SoC v3.0 — AXI4 Crossbar 3Mx5S + ASCON-128 DMA mode  
**Firmware:** `main.c` — ASCON encrypt via DMA engine  
**Toolchain:** `riscv64-unknown-elf-gcc 13.2.0` — `-march=rv32im -mabi=ilp32 -O0`

---

## Kiến trúc SoC

```
riscv_cpu_core
  ├─ imem_*  ──────────────► icache_top  (M0) ─┐
  └─ dcache_* ─────────────► dcache_top  (M1) ─┤
                                                ├─► axi4_crossbar_3m5s
ascon_ip_top (DMA)                              │     S0: IMEM  0x0000_0000 (64KB ROM)
  └─ M_AXI (64-bit) ──► width_conv_64to32 ──► M2    S1: DMEM  0x1000_0000 (64KB RAM)
  └─ S_AXI  ◄────────────────────────────── S2       S2: ASCON 0x2000_0000 (4KB)
                                                      S3: SoCCtrl 0x3000_0000
                                                      S4: CLINT   0x4000_0000
```

---

## Luồng firmware (main.c)

| Bước | Hàm | Mô tả |
|---|-----|---|
| 1 | `step1_prepare_dmem()` | Ghi PTEXT, KEY, NONCE snapshot vào DMEM |
| 2 | `step2_reset_ascon()` | Phát `CTRL=SOFT_RST`, chờ 2 NOP |
| 3 | `step3_write_key_nonce()` | Ghi KEY/NONCE vào ASCON registers |
| 4 | `step4_config_dma()` | Ghi DMA_SRC/DST/LEN + AXI barrier |
| 5 | `step5_set_mode_and_start()` | Ghi MODE, IRQ_EN, CTRL=DMA_EN rồi CTRL=DMA_EN\|START |
| 6 | `step6_wait_done()` | Poll STATUS.DMA_DONE với timeout 200000 |
| 7 | `step7_soft_rst_cleanup()` | SOFT_RST để clear DONE flag |

**DMEM layout sau khi xong:**

| Địa chỉ | Nội dung | Size |
|---|---|---|
| `0x1000_0000` | Plaintext (input) | 8B |
| `0x1000_0010` | Ciphertext (output DMA) | 8B |
| `0x1000_0020` | Auth Tag (output DMA) | 16B |
| `0x1000_0030` | KEY snapshot (debug) | 16B |
| `0x1000_0040` | NONCE snapshot (debug) | 16B |
| `0x1000_0050` | DATA_LEN (debug) | 4B |
| `0x1000_0054` | STATUS register | 4B |
| `0x1000_0058` | Return code (0=OK/-1=ERR/-2=TIMEOUT) | 4B |

---

## Lịch sử lỗi và cách sửa

---

### Lỗi #1 — PTEXT ghi sai địa chỉ `0x48657000`

**Triệu chứng:**
```
[ST] addr=0x48657000  data=0x48656c6c   ← "Hell" ghi vào địa chỉ rác
[ST] addr=0x48657004  data=0x6f210000
[!!!] DECERR count: 7
DMEM[0x10000000] = 0x00000000           ← plaintext trống
```

**Nguyên nhân:**  
`static const uint32_t PTEXT[4]` khiến GCC đặt data vào section `.srodata` (small read-only data). Linker script chỉ có `*(.rodata*)`, không capture `.srodata` → linker đặt section sai vị trí. GCC tính địa chỉ PTEXT bằng `lui+addi` dựa trên vị trí `.srodata` trong binary → offset sai → CPU ghi vào `0x48657000` (chính là giá trị `0x4865` = "He" của PTEXT bị nhầm thành địa chỉ).

**Fix:**  
Đổi `static const uint32_t[]` sang `#define`:

```c
// TRƯỚC — GCC sinh .srodata, địa chỉ bị tính sai
static const uint32_t PTEXT[2] = { 0x48656C6Cu, 0x6F210000u };

// SAU — GCC embed thẳng vào li/addi, không cần load từ memory
#define PTEXT_0  0x48656C6Cu
#define PTEXT_1  0x6F210000u
```

Assembly kết quả:
```asm
li  a4, 0x48656C6C    ← giá trị embed trực tiếp vào instruction
sw  a4, 0(a5)         ← ghi vào DMEM đúng địa chỉ
```

**Cũng sửa thêm trong `compile_c_to_hex.sh`:**
- Linker script: thêm `*(.srodata*)` và `*(.sdata2*)` vào ROM section
- objcopy: đổi từ `--only-section` sang `--remove-section` để tự động capture mọi section nhỏ
- Compile flag: thêm `-mno-relax -fno-pic`

---

### Lỗi #2 — KEY/NONCE ghi vào IMEM `0x00000000`

**Triệu chứng:**
```
[ST] addr=0x00000000  data=0x6f210000   ← ghi đè IMEM!
[ST] addr=0x00000004  data=0x44556677
[WARN] M1(DCache) AR -> IMEM range! addr=0x00000000
```

**Nguyên nhân:** Cùng nguyên nhân với Lỗi #1 — `static const uint32_t KEY[4]` và `NONCE[4]` cũng bị đặt vào `.rodata` với địa chỉ tính sai.

**Fix:** Cùng fix với Lỗi #1 — đổi toàn bộ sang `#define`.

---

### Lỗi #3 — `core_start=0`, `dma_start=0` — ASCON không phản hồi

**Triệu chứng:**
```
core_start pulses : 0
dma_start  pulses : 0
S2 ASCON accesses : 4   ← CPU ghi được vào ASCON nhưng không trigger
STATUS at halt    : 0x00000000
```

**Nguyên nhân:**  
Ghi `CTRL = CTRL_DMA_EN | CTRL_START = 0x05` trong một lần duy nhất. RTL có thể xử lý `DMA_EN` (bit 2) và `START` (bit 0) ở 2 clock edge khác nhau — `START` được sample trước khi `reg_dma_en` được latch → DMA không start, core không start.

**Fix:** Tách thành 2 lần ghi:

```c
// TRƯỚC
ASCON_CTRL = CTRL_DMA_EN | CTRL_START;   // 0x05 — không trigger

// SAU
ASCON_CTRL = CTRL_DMA_EN;                // latch reg_dma_en = 1
__asm__ volatile ("nop");
__asm__ volatile ("nop");
ASCON_CTRL = CTRL_DMA_EN | CTRL_START;   // START với DMA_EN ổn định
```

---

### Lỗi #4 — `core_start=1` nhưng `dma_start=0`

**Triệu chứng:**
```
core_start pulses : 1   ← core chạy (CPU-direct mode)
dma_start  pulses : 0   ← DMA không chạy
[ASCON] CORE DONE #1
DMEM[0x10000010] = 0x00000000   ← ciphertext trống
```

Store Scoreboard:
```
[0x20000000] = 0x00000001   ← CTRL chỉ có START bit, không có DMA_EN!
```

**Nguyên nhân:**  
Sau fix Lỗi #3, lần ghi thứ 2 chỉ là `CTRL = CTRL_START = 0x01`. RTL thấy `DMA_EN=0` trong write data → chỉ trigger **core** (CPU-direct mode), không trigger DMA engine.

**Fix:**

```c
// TRƯỚC (sai) — lần 2 thiếu DMA_EN
ASCON_CTRL = CTRL_START;             // 0x01 → core start, DMA không start

// SAU (đúng) — giữ DMA_EN trong cả 2 lần ghi
ASCON_CTRL = CTRL_DMA_EN | CTRL_START;   // 0x05 → DMA start
```

---

### Lỗi #5 (hiện tại) — `dma_start=1` nhưng `src=0x00000000`

**Triệu chứng:**
```
[ASCON] DMA START #1  src=0x00000000  dst=0x00000000  len=8
[DMA64-AR] addr=0x00000000  (64-bit side)
[WARN] M2(DMA) AR outside DMEM range! addr=0x00000000
dma_busy = 1   ← stuck, không bao giờ done
dma_done = 0
```

Store Scoreboard xác nhận CPU đã ghi đúng:
```
[0x20000100] = 0x10000000   ← DMA_SRC đúng ✓
[0x20000104] = 0x10000010   ← DMA_DST đúng ✓
[0x20000108] = 0x00000018   ← DMA_LEN=24 đúng ✓
```

Nhưng `DMA config at halt: src=0x00000000` — RTL đọc `reg_dma_src = 0`.

**Nguyên nhân:**  
Khi `CTRL=START` được assert, `ascon_dma` latch `reg_dma_src/dst/len` ngay tại clock edge đó. Tuy nhiên các AXI write ghi `DMA_SRC/DST/LEN` vào slave register chưa được commit (AW+W+B handshake chưa hoàn tất) → DMA latch giá trị cũ `0x00000000`.

Timeline:
```
cycle 238  ST → 0x20000100 = 0x10000000  (DMA_SRC write issued)
cycle 268  ST → 0x20000000 = 0x00000005  (CTRL=START)
           ↑ AXI write chưa chắc đã hoàn tất!
```

**Fix:** Thêm AXI write barrier (read-back fence) sau khi ghi DMA config:

```c
static void step4_config_dma(void)
{
    volatile uint32_t fence;

    ASCON_DMA_SRC = DMEM_BASE + DMEM_PTEXT_OFF;
    ASCON_DMA_DST = DMEM_BASE + DMEM_CTEXT_OFF;
    ASCON_DMA_LEN = DMA_TOTAL_LEN;

    // AXI write barrier: đọc lại DMA_SRC để force drain AXI write pipeline
    // CPU phải chờ read data về → đảm bảo mọi write trước đó đã commit
    fence = ASCON_DMA_SRC;
    (void)fence;
}
```

**Trạng thái:** Đang chờ xác nhận kết quả sau fix này.

---

## Trạng thái tổng hợp

| Hạng mục | Trạng thái |
|---|---|
| DMEM PTEXT, KEY, NONCE | ✅ Đúng |
| ASCON KEY, NONCE registers | ✅ Đúng |
| ASCON DMA_SRC/DST/LEN registers | ✅ Ghi đúng (CPU side) |
| DECERR | ✅ = 0 |
| `core_start` | ✅ = 1 |
| `dma_start` | ✅ = 1 |
| DMA latch đúng `src=0x10000000` | ❌ Đang fix (barrier) |
| `dma_done` | ❌ Chưa |
| DMEM ciphertext + auth tag | ❌ Chưa |

---

## File liên quan

| File | Mô tả |
|---|---|
| `main.c` | Firmware chính — v2.0 fixed |
| `compile_c_to_hex.sh` | Build script — v2.0 fixed |
| `ascon_regs.h` | ASCON register map |
| `dmem_layout.h` | DMEM memory layout |
| `run.sh` | Script tổng hợp compile + sim |
