ChiThang12/Design_SoC_RISCV_ASCON/debug/bug_report_patch.docx

# RISC-V SoC ASCON — Bug Report & Patch Summary

Phân tích từ: debug_data.v · main.c · ascon_regs.h · dmem_layout.h · axi4_addr_decoder.v · soc_top.v · ascon_axi_slave.v

## 1. Tổng quan

ID | File | Mô tả vấn đề | Trạng thái | Hành động
BUG-1 | main.c step3() | DMEM->DATALEN ghi = 24 (output length) thay vì 8 (plaintext length) | BUG XAC NHAN | Sua 1 dong trong main.c
BUG-2 | axi4_addr_decoder.v | S1_MASK default = 0xFFFF_0000 (64KB) khong khop soc_top 0xFFFF_E000 (8KB) | BUG XAC NHAN | Sua 1 dong trong decoder.v
BUG-3 | SoC_Register_Map.docx | Register 0x2000_005C (ADDR_DATA_LEN) co trong RTL nhung thieu trong tai lieu | TAI LIEU THIEU | Bo sung vao register map
OK-1 | main.c step4() | DMA_LEN=24 la DUNG theo thiet ke (DMA ghi 8B ctext + 16B tag) | DUNG, RUT LAI | Khong thay doi
OK-2 | dmem_layout.h | TAG_0..TAG_3 overlap DMA range la chu y — DMA ghi TAG truc tiep | DUNG, RUT LAI | Khong thay doi
OK-3 | Testbench log | WARN M1 AW=28 vs S1 AW=8: 20 AW den dung S2 ASCON, khong phai drop | DUNG, RUT LAI | Sua assertion testbench

## 2. BUG-1 — main.c DMEM->DATALEN sai gia tri

Truoc khi sua (SAI) | Sau khi sua (DUNG)
DMEM->DATALEN = DMEM_DMA_OUTPUT_LEN; // = 24 <-- SAI | DMEM->DATALEN = DMA_PTEXT_LEN; // = 8 <-- DUNG
DMEM->DATALEN la truong luu "so byte plaintext da xu ly". Ghi 24 (output length) sai y nghia. Khong anh huong DMA hardware nhung sai semantic, de gay nham khi doc lai trang thai. | Plaintext = 8 bytes (PTEXT_0 + PTEXT_1). Ghi DMA_PTEXT_LEN = 8.

## 3. BUG-2 — axi4_addr_decoder.v S1_MASK default sai

Truoc khi sua (SAI) | Sau khi sua (DUNG)
parameter [ADDR_WIDTH-1:0] S1_MASK = 32'hFFFF_0000, // 64KB | parameter [ADDR_WIDTH-1:0] S1_MASK = 32'hFFFF_E000, // 8KB
soc_top truyen dung 0xFFFF_E000 xuong nen hien tai khong crash. Nhung default decoder sai, neu ai re-use module nay rieng le se bug. | Dong bo voi soc_top default va DMEM_SIZE = 8192 = 8KB.

## 4. BUG-3 — Register 0x2000_005C thieu trong tai lieu (can bo sung)

Dia chi | Ten Register | R/W | Mo ta
0x2000_005C | ADDR_DATA_LEN | RW | bit[6:0]: So byte plaintext ASCON core xu ly (max 16 bytes). Reset default = 7'd8 (8 bytes). Firmware PHAI ghi register nay neu PT != 8 bytes truoc khi ghi CTRL_DMA_START. Co trong ascon_axi_slave.v nhung THIEU trong SoC_Register_Map.docx.

## 5. Ghi chu testbench — WARN M1 AW != S1 AW la sai cua assertion

28 AW tren M1 = 8 (den S1 DMEM) + 20 (den S2 ASCON MMIO). Crossbar route dung, khong co write nao bi drop. Sua assertion:

Assertion sai hien tai | Assertion dung can sua
if (s1_aw_count != m1_aw_count) $display("[WARN] S1 AW count (%0d) != M1+M2 AW (%0d)...", s1_aw_count, m1_aw_count + m2_aw_count); | if (s1_aw_count + s2_aw_count != m1_aw_count) $display("[WARN] AW mismatch: S1(%0d)+S2(%0d) != M1(%0d)", s1_aw_count, s2_aw_count, m1_aw_count);
