ChiThang12/Design_SoC_RISCV_ASCON/(commit log)

2026-02-02 Cache in Interface was fixed
    [data_mem_burst.v, dcache_axi_interface.v, dcache_controller.v, dcache_data_array.v, dcache_tag_array.v, dcache_top.v, tb_data_array.v, tb_tag_array.v]
2026-02-04 add DMA to ASCON
2026-02-13 INTR MEM are currently being fixed
    [cpu_core.v, data_mem_axi_slave.v, data_mem_burst.v, dcache_axi_interface.v, dcache_controller.v, dcache_data_array.v, dcache_tag_array.v, dcache_top.v]
2026-03-17 Fix bug 3D - Dcache Dmem DMA
    [dma_ctrl_fsm.v, run_soc_ascon.v, soc_top.v]
2026-03-29 msource synthesis
    [FA_Reg__max_ff_n40C_1v95.sdf, FA_Reg__max_ss_100C_1v60.sdf, FA_Reg__max_tt_025C_1v80.sdf, FA_Reg__min_ff_n40C_1v95.sdf, FA_Reg__min_ss_100C_1v60.sdf, FA_Reg__min_tt_025C_1v80.sdf, FA_Reg__nom_ff_n40C_1v95.sdf, FA_Reg__nom_ss_100C_1v60.sdf]
2026-03-29 source synthesis
    [metrics.csv]
2026-05-08 Revert broken session fixes: nc_just_completed (dcache) + FIX-LSU-CONFLICT (LSU)
    nc_just_completed trong dcache_controller.v không fix được duplicate UART write
    vì bị skip khi flush_busy=1. FIX-LSU-CONFLICT trong LSU.v gây drop char 't'
    và '\r'. Revert cả hai về state 61018ff để debug lại từ đầu.
    [LSU.v, dcache_controller.v]
2026-05-18 Pass 5/10 test case
2026-06-18 ver 4 begin
    [Bảng so sánh RISC-V core-platform-fabricated - Cores.csv, Bảng so sánh RISC-V core-platform-fabricated - Fabricated SoCs.csv, Bảng so sánh RISC-V core-platform-fabricated - SoC Platforms.csv, Bảng so sánh RISC-V core-platform-fabricated.xlsx]
2026-06-28 ver 5
    [sweep_results.csv]
2026-06-29 add source ver 5
    [h3_fair_comparison.csv]
